MAKERS-DEVELOPMENT-GROUP/MDG-CR-10-V3-Project/BOM/MDG CR-10 V3 - BOM R1.xlsx

Sheet: READ ME
Thank you for your interest in MAKERS DEVELOPMENT GROUP, LLC'S CR-10 upgrade project.
AQUIRING PARTS FOR THE BUILD
There are many ways to build your MDG CR-10.
MDG is now offering our popular MDG CR-10 Upgrade kit with all 3D printed parts. You're welcome to print & source your own parts and upgrade your CR-10 3D printer.
This option is for those that enjoy sourcing all the componets and printing their own parts.
Please use our affiliate links on the BOM page to support our business and enable us to provide more designs.
For amazon links please note the link expires after 24 hours so please make your purchase within that
time period so we can get credit.
Alternativly, you can Buy a Complete Kit directly from our webstore
This is the easiset option as all required parts will come from a single purchase.
***********************************************************************************************
Please note MDG makes all our own aluminum parts, we do not allow others to make them on our
behalf, please support our business by buying all aluminum parts directly from us.
engineering of any MDG parts is forebidden.
See LEGAL section for full tems of use pertaining to this BOM

Sheet: MDG CR-10 - BOM
MDG CR-10 V2/V3 UPGRADE PROJECT - BILL OF MATERIALS
ITEM | QTY | PART NUMBER | DESCRIPTION
1 | 1 | 10-0001 | MDG X-AXIS DUAL LINEAR RAIL PLATE, 400MM (https://github.com/MAKERS-DEVELOPMENT-GROUP/MDG-CR-10-V3-Project/tree/main/STL)
2 | 1 | 10-0002 | MDG TOOL BASE, CR-10 V2 /V3 (https://github.com/MAKERS-DEVELOPMENT-GROUP/MDG-CR-10-V3-Project/tree/main/STL)
3 | 1 | 10-0003 | MDG-EXTRUDER MOUNT, CR10-V2 / V3 (https://github.com/MAKERS-DEVELOPMENT-GROUP/MDG-CR-10-V3-Project/tree/main/STL)
4 | 1 | 10-0004 | MDG DUAL-Y LINEAR RAIL MOUNT, CR10 V2 / V3 LEFT (https://github.com/MAKERS-DEVELOPMENT-GROUP/MDG-CR-10-V3-Project/tree/main/STL)
5 | 1 | 10-0005 | MDG DUAL-Y LINEAR RAIL MOUNT, CR10 V2 /V3 RIGHT (https://www.makersdevelopmentgroup.com/product-page/mdg-dual-y-linear-rail-mount-l-r-set-cr10-v2-v3)
6 | 3 | 10-0006 | MDG-X AXIS END STOP (https://www.makersdevelopmentgroup.com/product-page/x-axis-end-stop-cr-10)
7 | 1 | 10-0007 | MDG-X AXIS LIMIT SWITCH PLATE (https://www.makersdevelopmentgroup.com/product-page/x-axis-end-stop-cr-10)
8 | 1 | 10-0008 | MDG X-AXIS TIMING BELT CLAMP (https://www.makersdevelopmentgroup.com/product-page/gt2-timing-belt-clamp-vertical-6mm)
9 | 6 | 10-0009 | MDG Z AXIS SPACER (https://www.makersdevelopmentgroup.com/product-page/mdg-z-axis-spacer-cr-10)
10 | 1 | 10-0010 | MDG Z RAIL SUPPORT LEFT, CR10 (https://www.makersdevelopmentgroup.com/product-page/z-axis-linear-rail-mount-set-cr-10)
11 | 1 | 10-0011 | MDG Z RAIL SUPPORT RIGHT, CR10 (https://www.makersdevelopmentgroup.com/product-page/z-axis-linear-rail-mount-set-cr-10)
12 | 1 | 10-0012 | MDG Z RAIL UPPER SUPPORT, LEFT, CR10 / ENDER 3 (https://www.makersdevelopmentgroup.com/product-page/z-axis-linear-rail-mount-set-cr-10)
13 | 1 | 10-0013 | MDG Z RAIL UPPER SUPPORT, RIGHT, CR10 / ENDER 3 (https://www.makersdevelopmentgroup.com/product-page/z-axis-linear-rail-mount-set-cr-10)
14 | 1 | 10-0014 | MDG ADJUSTABLE Z-AXIS LIMIT SWITCH PLATE, CR-10 (https://www.makersdevelopmentgroup.com/product-page/adjustable-z-axis-limit-switch-plate-cr-10)
15 | 1 | 10-0034 | MDG SOLID BED LEVEL SPACER SET, CR-10/ENDER 3 (https://www.makersdevelopmentgroup.com/product-page/mdg-solid-bed-level-spacer-set-cr10-ender-3)
16 | 40 | HLN-M3X0.5 | HEX LOCK NUT (https://amzn.to/35UMeI6)
17 | 6 | HLN-M5X0.8 | HEX LOCK NUT (https://amzn.to/3pOCWFH)
18 | 1 | HLN-M6X1 | HEX LOCK NUT (https://amzn.to/3ft75W0)
19 | 2 | M119A2A154 | SHCS (https://amzn.to/3lYWwN7)
20 | 24 | M119A2A160 | SHCS (https://amzn.to/35XCZqU)
21 | 88 | M119A2A161 | SHCS (https://amzn.to/33bXQF0)
22 | 40 | M119A2A162 | SHCS (https://amzn.to/33afzwA)
23 | 7 | M119A2A163 | SHCS (https://amzn.to/35WZcoV)
24 | 7 | M119A2A164 | SHCS (https://amzn.to/3989sws)
25 | 10 | M119A2A178 | SHCS (https://amzn.to/398aKaN)
26 | 6 | M119A2A188 | SHCS (https://amzn.to/35UjjUH)
27 | 16 | M120A2A178 | BHCS (https://amzn.to/2URF0hE)
28 | 4 | M12A5C3 | PLAIN WASHER (https://amzn.to/3nUd3T7)
29 | 6 | M12A5C5 | PLAIN WASHER (https://amzn.to/3kXEGbZ)
30 | 1 | MDG-GT2B-2P-6W-1M | GT2 BELT (https://amzn.to/2KtRpXb)
31 | 2 | MDG-LR09-1H-400 | LINEAR RAIL, 9MM X 400MM, SS (https://amzn.to/3pNZeqW)
32 | 2 | MDG-LR12-1H-500 | LINEAR RAIL, 12MM (https://amzn.to/39735JJ)
33 | 2 | MDG-LR12-2H-450 | LINEAR RAIL, 12MM WITH 2 H-STYLE CARRIAGES, SS (https://amzn.to/2KvB18F)
34 | 1 | SB-A201 | SHOULDER BOLT (https://www.mcmaster.com/92981A201/)
35 | 1 | SBS-A263 | SHIM (https://www.mcmaster.com/91437A263/)
36 | 1 | SBS-A282 | SHIM (https://www.mcmaster.com/91437A282/)
37 | 76 | TN-2020-M3 | T-NUT, 2020 (https://amzn.to/3pWzc55)
38 | 20 | TN-2020-M5 | T-NUT, 2020 (https://amzn.to/2IViW3E)

Sheet: MDG CR-10 - OPTIONAL BOM
ITEM | DESCRIPTION | NOTES
1 | CREALITY CR-10 V3 (https://amzn.to/3G3XJhp) | BASE 3D PRINTER FOR BUILD PROJECT
2 | NEMA 17 STEPPER, 60 MM (https://amzn.to/3fveRPh) | FOR ADDED TORQUE / SPEED ON X/Y AXIS
3 | NEMA 17 STEPPER, 23 MM (https://amzn.to/3fptTWO) | FOR REDUCED WEIGHT OF DIRECT DRIVE EXTRUDER
4 | BTT SKR 1.4 TURBO W/(5) TMC2208 (https://amzn.to/33axjaS) | UPGRADED CONTROL BOARD.
5 | BTT SKR 1.4 TURBO W/(5) TMC2209 (https://amzn.to/35VlbfJ) | UPGRADED CONTROL BOARD.
6 | BTT SKR 1.4 TURBO W/(5) TMC2209 & TFT35 V3.0 (https://amzn.to/397sxPg) | UPGRADED CONTROL BOARD & TOUCH SCREEN
7 | ULTISTIK TEXTURED PEI SHEET (https://amzn.to/2KDglvL) | GREAT FOR PETG
8 | ANTI-BACKLASH NUTS (https://amzn.to/398N1qR) | SMOOTHER THEN OEM BRASS LEADNUTS
9 | BL TOUCH KIT, CR-10 V2 / V3 (https://amzn.to/338vFGM) | BED LEVELING KIT COMPATABLE WITH MDG UPGRADES
10 | SILICONE SOCK (https://amzn.to/3nVYuyt) | REPLACEMENT SOCK
11 | 3-2-1 MACHINE BLOCKS (https://amzn.to/395D0ed) | FOR SQUARING X-AXIS TO THE BED
13 | DIAL INDICATOR (https://amzn.to/2UT79F9) | FOR ALIGNING LINEAR RAILS PERFECTLY
14 | DIAL INDICATOR MAGNETIC BASE (https://amzn.to/3nTv9Vl) | DIAL INDICATOR MOUNT

Sheet: LEGAL
LEGAL TERMS
THIS BILL OF MATERIAL AND DATA EMBODY PROPRIETARY INFORMATION WHICH IS THE CONFIDENTIAL
PROPERTY OF MAKERS DEVELOPMENT GROUP, LLC AND SHALL NOT BE COPIED, REPRODUCED, DISCLOSED
TO OTHERS, OR OTHERWISE USED IN WHOLE OR IN PART IN ANY MATTER PREJUDICIAL TO THE
INTERESTS OF MAKERS DEVELOPMENT GROUP, LLC WITHOUT EXPRESS WRITTEN CONSENT OF MAKERS
DEVELOPMENT GROUP, LLC. MAKERS DEVELOPMENT GROUP, LLC EXPRESSLY RESERVES ALL DESIGN,
MANUFACTURING USE, REPRODUCTION AND SALES RIGHTS IN AND TO ALL INFORMATION CONTAINED IN
OR DISCLOSED BY THIS DOCUMENT. THIS BILL OF MATERIAL IS LOANED IN CONFIDENCE WITH THE
UNDERSTANDING IT SHALL BE RETURNED ON DEMAND. ACCEPTANCE OF THIS BILL OF MATERIAL SHALL
BE CONSTRUED AS AN AGREEMENT TO OBSERVE THE FOREGOING CONDITIONS AND AS AN ADMISSION
THAT MAKERS DEVELOPMENT GROUP, LLCIS THE EXCLUSIVE OWNER OF THIS BILL OF MATERIAL.
"MAKERS DEVELOPMENT GROUP, LLCEXPRESSLY RESERVES ALL DESIGN, MANUFACTURING USE,
REPRODUCTION, SALES RIGHTS IN AND TO ALL INFORMATION CONTAINED OR DISCLOSED BY THIS
DOCUMENT."
