MAKERS-DEVELOPMENT-GROUP/MDG-CR-10-V3-Project/BOM/MDG CR-10 V3 - BOM R0.xlsx

Sheet: READ ME
Thank you for your interest in MAKERS DEVELOPMENT GROUP, LLC'S CR-10 upgrade project.
AQUIRING PARTS FOR THE BUILD
There are many ways to build your MDG CR-10.
1.) Buy a Complete Kit directly from our webstore
This is the easiset option as all required parts will come from a single purchase from our webstore.
As such this is our recommneded option.
2.) Buy each axis upgrade individually from our webstore
This is the option if you wish to upgrade over time. If you go down this path we recommend upgrading
the Y-axis first, X-axis second, and Z-axis third. You can purchase each axis upgrade kit directly from our webstore
3.) Buy aluminum parts & 3D printed parts kit from our store.
This option is for those that enjoy sourcing all the componets themselves.
Please use our affiliate links so theY can support our business and enable us to provide more designs.
For amazon links please note the link expires after 24 hours so please make your purchase within that
time period so we can get credit.
Please note by the time you factor in shipping costs from multiple sources this will likely be more
expensive then just purchasing the kits from MDG
4.) Buy aluminum parts from our webstore & 3D print your own parts
This option is for those that enjoy sourcing all the componets and printing their own parts.
Please use our affiliate links so the can support our business and enable us to provide more designs.
For amazon links please note the link expires after 24 hours so please make your purchase within that
time period so we can get credit.
***********************************************************************************************
Please note MDG makes all our own aluminum parts, we do not allow others to make them on our
behalf, please support our business by buying all aluminum parts directly from us. Reverse
engineering of any MDG parts is forebidden.
See LEGAL section for full tems of use pertaining to this BOM

Sheet: MDG CR-10 V3 - COMPLETE BOM
ITEM | QTY | PART NUMBER | DESCRIPTION | COST | EXT COST
1 | 1 | 10-0001 | MDG X-AXIS DUAL LINEAR RAIL PLATE, 400MM (https://www.makersdevelopmentgroup.com/product-page/mdg-x-axis-dual-linear-rail-plate-400-mm-cr-10) | $99.00 | $99.00
2 | 1 | 10-0002 | MDG TOOL BASE, CR-10 V2 /V3 (https://www.makersdevelopmentgroup.com/product-page/mdg-x-axis-tool-base-cr-10-v2-v3) | $39.00 | $39.00
3 | 1 | 10-0003 | MDG-EXTRUDER MOUNT, CR10-V2 / V3 (https://www.makersdevelopmentgroup.com/product-page/mdg-extruder-hotend-mount-cr-10-v2-v3) | $39.00 | $39.00
4 | 1 | 10-0004 | MDG DUAL-Y LINEAR RAIL MOUNT, CR10 V2 / V3 LEFT (https://www.makersdevelopmentgroup.com/product-page/mdg-dual-y-linear-rail-mount-l-r-set-cr10-v2-v3) | $57.95 | $57.95
5 | 1 | 10-0005 | MDG DUAL-Y LINEAR RAIL MOUNT, CR10 V2 /V3 RIGHT (https://www.makersdevelopmentgroup.com/product-page/mdg-dual-y-linear-rail-mount-l-r-set-cr10-v2-v3) |  | $0.00
6 | 3 | 10-0006 | MDG-X AXIS END STOP (https://www.makersdevelopmentgroup.com/product-page/x-axis-end-stop-cr-10) | $3.53 | $10.59
7 | 1 | 10-0007 | MDG-X AXIS LIMIT SWITCH PLATE (https://www.makersdevelopmentgroup.com/product-page/x-axis-end-stop-cr-10) | $3.53 | $3.53
8 | 1 | 10-0008 | MDG X-AXIS TIMING BELT CLAMP (https://www.makersdevelopmentgroup.com/product-page/gt2-timing-belt-clamp-vertical-6mm) | $3.93 | $3.93
9 | 6 | 10-0009 | MDG Z AXIS SPACER (https://www.makersdevelopmentgroup.com/product-page/mdg-z-axis-spacer-cr-10) | $4.95 | $29.70
10 | 1 | 10-0010 | MDG Z RAIL SUPPORT LEFT, CR10 (https://www.makersdevelopmentgroup.com/product-page/z-axis-linear-rail-mount-set-cr-10) | $3.53 | $3.53
11 | 1 | 10-0011 | MDG Z RAIL SUPPORT RIGHT, CR10 (https://www.makersdevelopmentgroup.com/product-page/z-axis-linear-rail-mount-set-cr-10) | $3.53 | $3.53
12 | 1 | 10-0012 | MDG Z RAIL UPPER SUPPORT, LEFT, CR10 / ENDER 3 (https://www.makersdevelopmentgroup.com/product-page/z-axis-linear-rail-mount-set-cr-10) | $3.53 | $3.53
13 | 1 | 10-0013 | MDG Z RAIL UPPER SUPPORT, RIGHT, CR10 / ENDER 3 (https://www.makersdevelopmentgroup.com/product-page/z-axis-linear-rail-mount-set-cr-10) | $3.53 | $3.53
14 | 1 | 10-0014 | MDG ADJUSTABLE Z-AXIS LIMIT SWITCH PLATE, CR-10 (https://www.makersdevelopmentgroup.com/product-page/adjustable-z-axis-limit-switch-plate-cr-10) | $3.53 | $3.53
15 | 1 | 10-0034 | MDG SOLID BED LEVEL SPACER SET, CR-10/ENDER 3 (https://www.makersdevelopmentgroup.com/product-page/mdg-solid-bed-level-spacer-set-cr10-ender-3) | $13.95 | $13.95
16 | 40 | HLN-M3X0.5 | HEX LOCK NUT (https://amzn.to/35UMeI6) | $6.99 | $6.99
17 | 6 | HLN-M5X0.8 | HEX LOCK NUT (https://amzn.to/3pOCWFH) | $8.19 | $8.19
18 | 1 | HLN-M6X1 | HEX LOCK NUT (https://amzn.to/3ft75W0) | $6.28 | $6.28
19 | 2 | M119A2A154 | SHCS (https://amzn.to/3lYWwN7) | $10.59 | $10.59
20 | 24 | M119A2A160 | SHCS (https://amzn.to/35XCZqU) | $8.19 | $8.19
21 | 88 | M119A2A161 | SHCS (https://amzn.to/33bXQF0) | $6.99 | $6.99
22 | 40 | M119A2A162 | SHCS (https://amzn.to/33afzwA) | $6.99 | $6.99
23 | 7 | M119A2A163 | SHCS (https://amzn.to/35WZcoV) | $8.98 | $8.98
24 | 7 | M119A2A164 | SHCS (https://amzn.to/3989sws) | $9.49 | $9.49
25 | 10 | M119A2A178 | SHCS (https://amzn.to/398aKaN) | $9.19 | $9.19
26 | 6 | M119A2A188 | SHCS (https://amzn.to/35UjjUH) | $10.59 | $10.59
27 | 16 | M120A2A178 | BHCS (https://amzn.to/2URF0hE) | $11.79 | $11.79
28 | 4 | M12A5C3 | PLAIN WASHER (https://amzn.to/3nUd3T7) | $4.99 | $4.99
29 | 6 | M12A5C5 | PLAIN WASHER (https://amzn.to/3kXEGbZ) | $7.29 | $7.29
30 | 1 | MDG-GT2B-2P-6W-1M | GT2 BELT (https://amzn.to/2KtRpXb) | $11.99 | $11.99
31 | 2 | MDG-LR09-1H-400 | LINEAR RAIL, 9MM X 400MM, SS (https://amzn.to/3pNZeqW) | $24.99 | $49.98
32 | 2 | MDG-LR12-1H-500 | LINEAR RAIL, 12MM (https://amzn.to/39735JJ) | $36.99 | $73.98
33 | 2 | MDG-LR12-2H-450 | LINEAR RAIL, 12MM WITH 2 H-STYLE CARRIAGES, SS (https://amzn.to/2KvB18F) | $45.99 | $91.98
34 | 1 | SB-A201 | SHOULDER BOLT (https://www.mcmaster.com/92981A201/) | $1.57 | $1.57
35 | 1 | SBS-A263 | SHIM (https://www.mcmaster.com/91437A263/) | $9.60 | $9.60
36 | 1 | SBS-A282 | SHIM (https://www.mcmaster.com/91437A282/) | $12.75 | $12.75
37 | 76 | TN-2020-M3 | T-NUT, 2020 (https://amzn.to/3pWzc55) | $7.99 | $7.99
38 | 20 | TN-2020-M5 | T-NUT, 2020 (https://amzn.to/2IViW3E) | $7.99 | $7.99
 |  |  |  |  | $698.67

Sheet: MDG CR-10 V3 - OPTIONAL BOM
ITEM | DESCRIPTION | NOTES
1 | CREALITY CR-10 V3 (https://amzn.to/398pPsV) | BASE 3D PRINTER FOR BUILD PROJECT
2 | NEMA 17 STEPPER, 60 MM (https://amzn.to/3fveRPh) | FOR ADDED TORQUE / SPEED ON X/Y AXIS
3 | NEMA 17 STEPPER, 23 MM (https://amzn.to/3fptTWO) | FOR REDUCED WEIGHT OF DIRECT DRIVE EXTRUDER
4 | BTT SKR 1.4 TURBO W/(5) TMC2208 (https://amzn.to/33axjaS) | UPGRADED CONTROL BOARD.
5 | BTT SKR 1.4 TURBO W/(5) TMC2209 (https://amzn.to/35VlbfJ) | UPGRADED CONTROL BOARD.
6 | BTT SKR 1.4 TURBO W/(5) TMC2209 & TFT35 V3.0 (https://amzn.to/397sxPg) | UPGRADED CONTROL BOARD & TOUCH SCREEN
7 | ULTISTIK TEXTURED PEI SHEET (https://amzn.to/2KDglvL) | GREAT FOR PETG
8 | ANTI-BACKLASH NUTS (https://amzn.to/398N1qR) | SMOOTHER THEN OEM BRASS LEADNUTS
9 | BL TOUCH KIT, CR-10 V2 / V3 (https://amzn.to/338vFGM) | BED LEVELING KIT COMPATABLE WITH MDG UPGRADES
10 | SILICONE SOCK (https://amzn.to/3nVYuyt) | REPLACEMENT SOCK
11 | 3-2-1 MACHINE BLOCKS (https://amzn.to/395D0ed) | FOR SQUARING X-AXIS TO THE BED
13 | DIAL INDICATOR (https://amzn.to/2UT79F9) | FOR ALIGNING LINEAR RAILS PERFECTLY
14 | DIAL INDICATOR MAGNETIC BASE (https://amzn.to/3nTv9Vl) | DIAL INDICATOR MOUNT

Sheet: LEGAL
LEGAL TERMS
THIS BILL OF MATERIAL AND DATA EMBODY PROPRIETARY INFORMATION WHICH IS THE CONFIDENTIAL
PROPERTY OF MAKERS DEVELOPMENT GROUP, LLC AND SHALL NOT BE COPIED, REPRODUCED, DISCLOSED
TO OTHERS, OR OTHERWISE USED IN WHOLE OR IN PART IN ANY MATTER PREJUDICIAL TO THE
INTERESTS OF MAKERS DEVELOPMENT GROUP, LLC WITHOUT EXPRESS WRITTEN CONSENT OF MAKERS
DEVELOPMENT GROUP, LLC. MAKERS DEVELOPMENT GROUP, LLC EXPRESSLY RESERVES ALL DESIGN,
MANUFACTURING USE, REPRODUCTION AND SALES RIGHTS IN AND TO ALL INFORMATION CONTAINED IN
OR DISCLOSED BY THIS DOCUMENT. THIS BILL OF MATERIAL IS LOANED IN CONFIDENCE WITH THE
UNDERSTANDING IT SHALL BE RETURNED ON DEMAND. ACCEPTANCE OF THIS BILL OF MATERIAL SHALL
BE CONSTRUED AS AN AGREEMENT TO OBSERVE THE FOREGOING CONDITIONS AND AS AN ADMISSION
THAT MAKERS DEVELOPMENT GROUP, LLCIS THE EXCLUSIVE OWNER OF THIS BILL OF MATERIAL.
"MAKERS DEVELOPMENT GROUP, LLCEXPRESSLY RESERVES ALL DESIGN, MANUFACTURING USE,
REPRODUCTION, SALES RIGHTS IN AND TO ALL INFORMATION CONTAINED OR DISCLOSED BY THIS
DOCUMENT."
