MAKERS-DEVELOPMENT-GROUP/MDG-CR-10-V3-Project/STL/10-0001A#FDM.stl

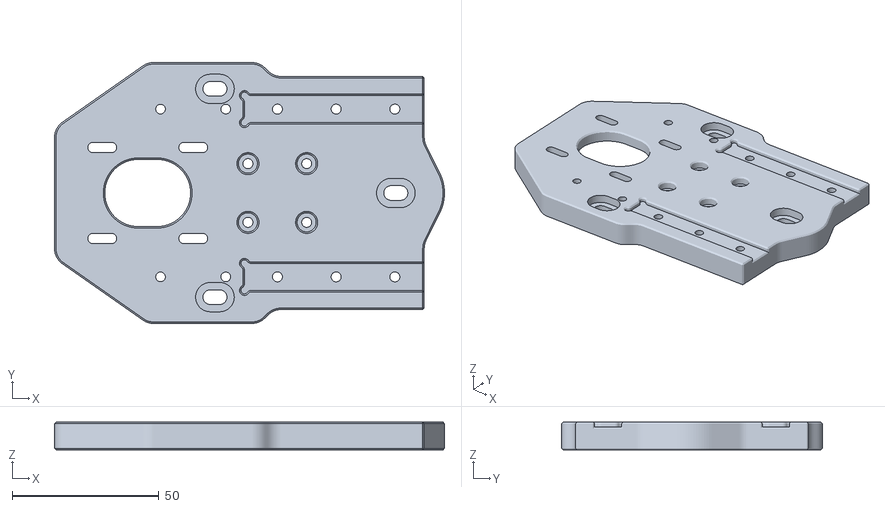
[picture p1: CAD file, 2022-12-29]
STL/10-0001A#FDM.stl
132.9 x 88.9 x 9.52
