MAKERS-DEVELOPMENT-GROUP/MDG-CR-10-V3-Project/STL/10-0001B#FDM.stl

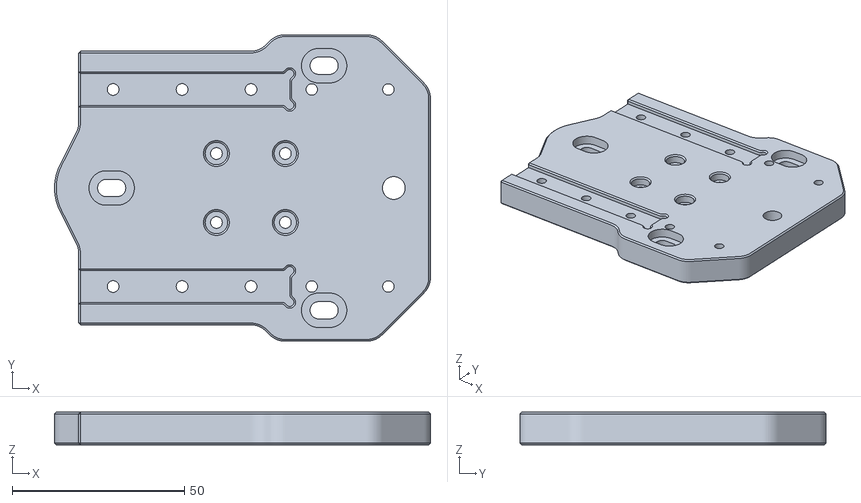
[picture p2: CAD file, 2022-12-29]
STL/10-0001B#FDM.stl
109.1 x 88.9 x 9.52
