MAKERS-DEVELOPMENT-GROUP/MDG-CR-10-V3-Project/STL/10-0001C#FDM.stl

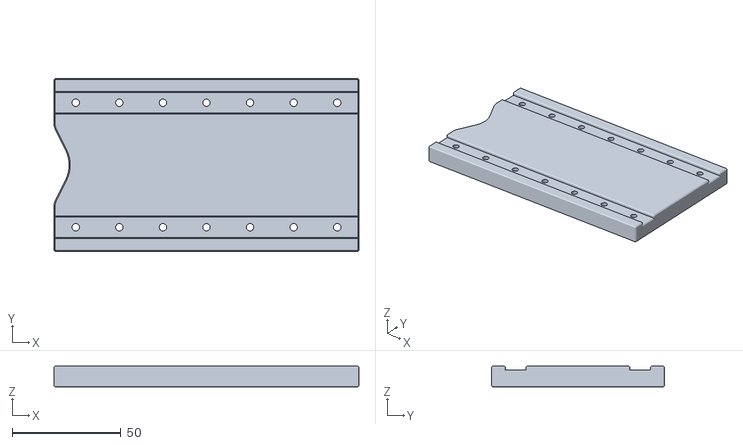
[picture p3: CAD file, 2022-12-29]
STL/10-0001C#FDM.stl
140.0 x 79.4 x 9.52
