MAKERS-DEVELOPMENT-GROUP/MDG-CR-10-V3-Project/STL/10-0002#FDM.stl

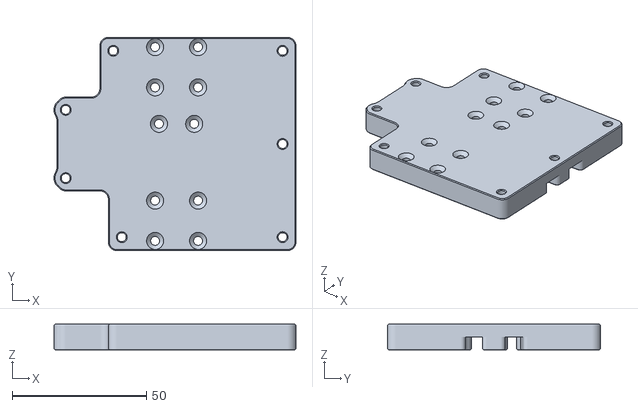
[picture p4: CAD file, 2022-12-29]
STL/10-0002#FDM.stl
90.1 x 79.4 x 9.52
