MAKERS-DEVELOPMENT-GROUP/MDG-CR-10-V3-Project/STL/10-0009#FDM.stl

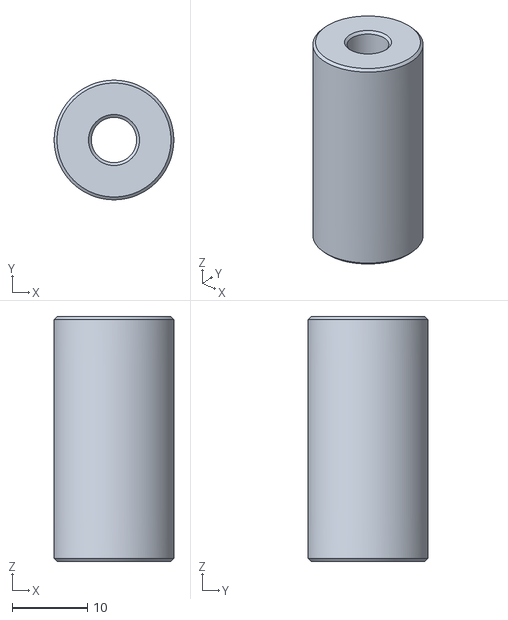
[picture p5: CAD file, 2022-12-29]
STL/10-0009#FDM.stl
15.9 x 15.9 x 32.5
