MAKERS-DEVELOPMENT-GROUP/MDG-CR-10-V3-Project/STL/10-0003#FDM.stl

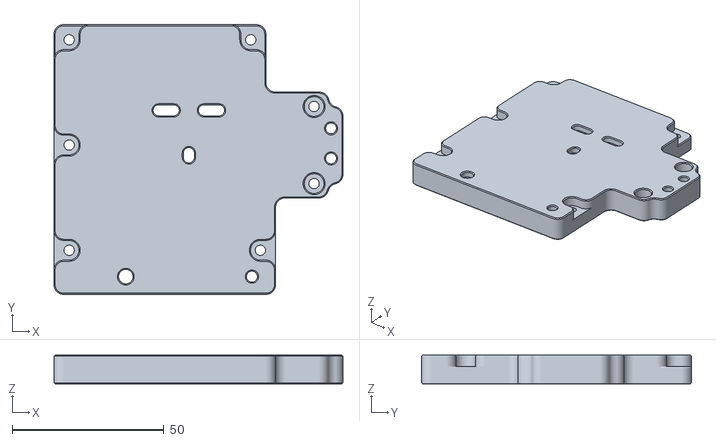
[picture p6: CAD file, 2022-12-29]
STL/10-0003#FDM.stl
95.2 x 88.9 x 9.52
