MAKERS-DEVELOPMENT-GROUP/MDG-CR-10-V3-Project/STL/10-0004#FDM.stl

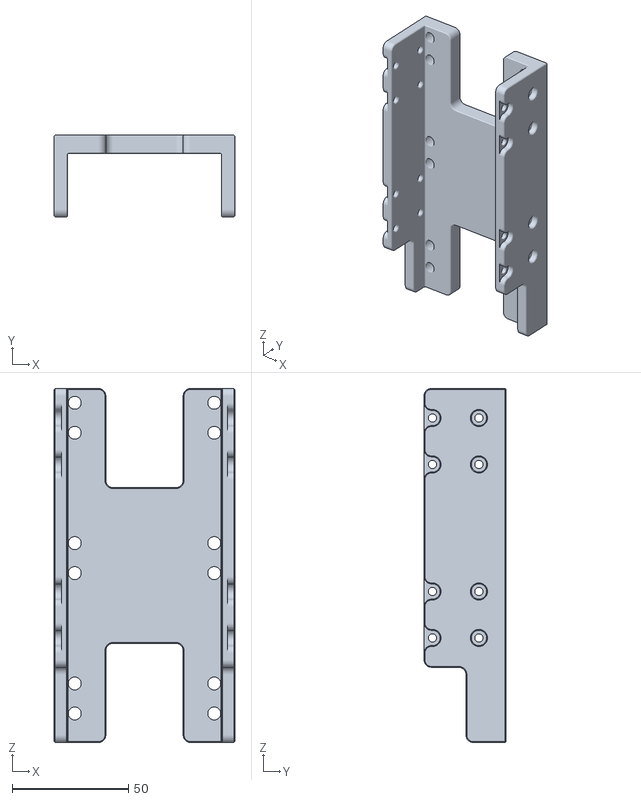
[picture p7: CAD file, 2022-12-29]
STL/10-0004#FDM.stl
77.7 x 35.3 x 152.4
