MAKERS-DEVELOPMENT-GROUP/MDG-CR-10-V3-Project/STL/10-0008#0.stl

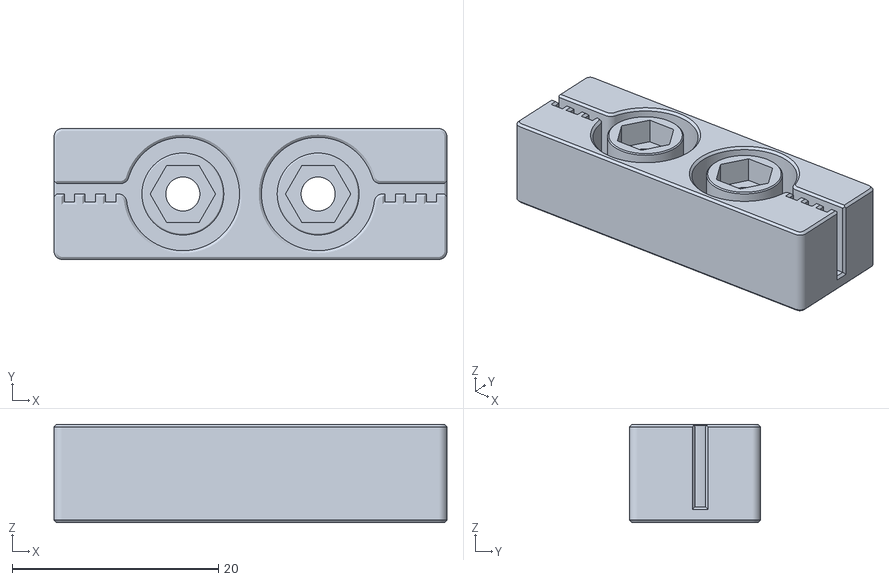
[picture p8: CAD file, 2022-12-29]
STL/10-0008#0.stl
38.1 x 12.7 x 9.52
