MAKERS-DEVELOPMENT-GROUP/MDG-CR-10-V3-Project/STL/10-0051B.stl

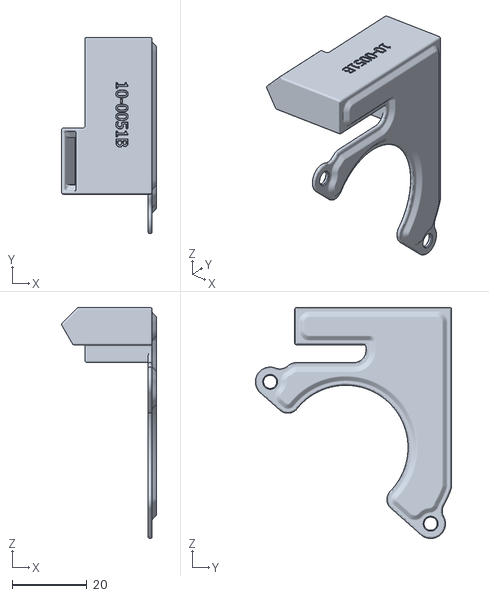
[picture p9: CAD file, 2021-04-24]
STL/10-0051B.stl
25.4 x 52.6 x 61.9
