MAKERS-DEVELOPMENT-GROUP/MDG-CR-10-V3-Project/STL/10-0003#9.stl

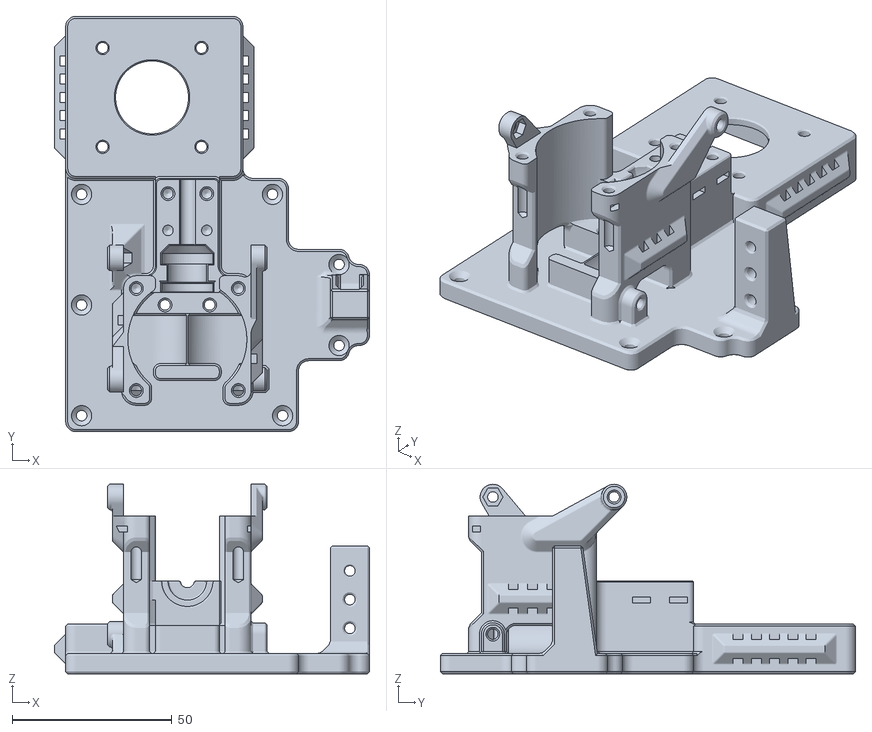
[picture p11: CAD file, 2021-04-24]
STL/10-0003#9.stl
98.7 x 130.2 x 59.4
