MAKERS-DEVELOPMENT-GROUP/MDG-CR-10-V3-Project/STL/10-0003#7.stl

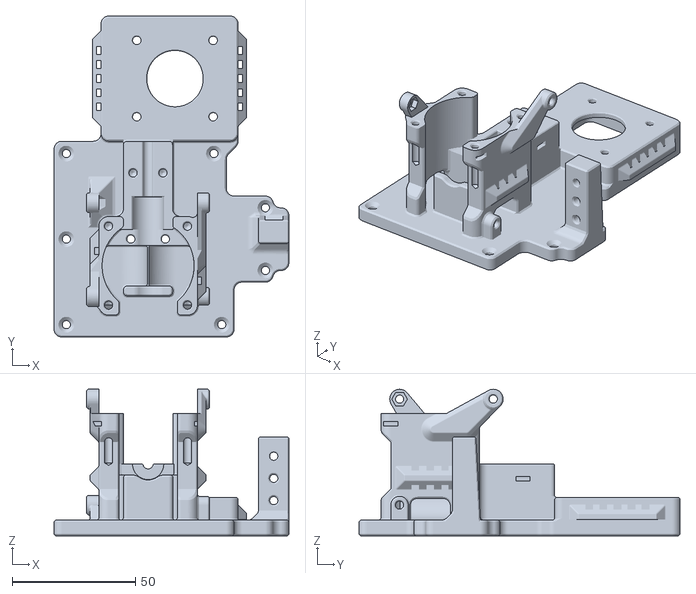
[picture p12: CAD file, 2021-04-24]
STL/10-0003#7.stl
95.2 x 130.2 x 59.4
