MAKERS-DEVELOPMENT-GROUP/MDG-CR-10-V3-Project/STL/10-0003#0.stl

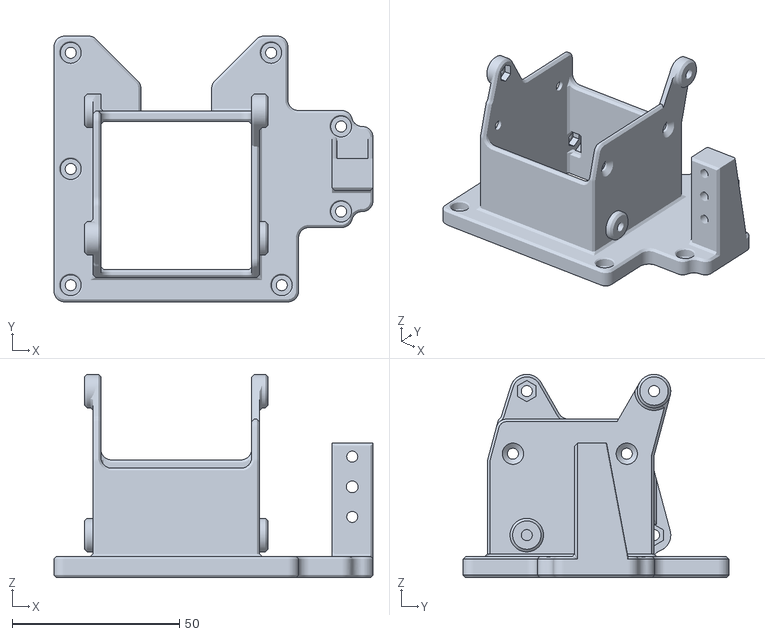
[picture p13: CAD file, 2021-04-24]
STL/10-0003#0.stl
95.2 x 79.4 x 60.7
