MAKERS-DEVELOPMENT-GROUP/MDG-CR-10-V3-Project/STL/10-0018A.stl

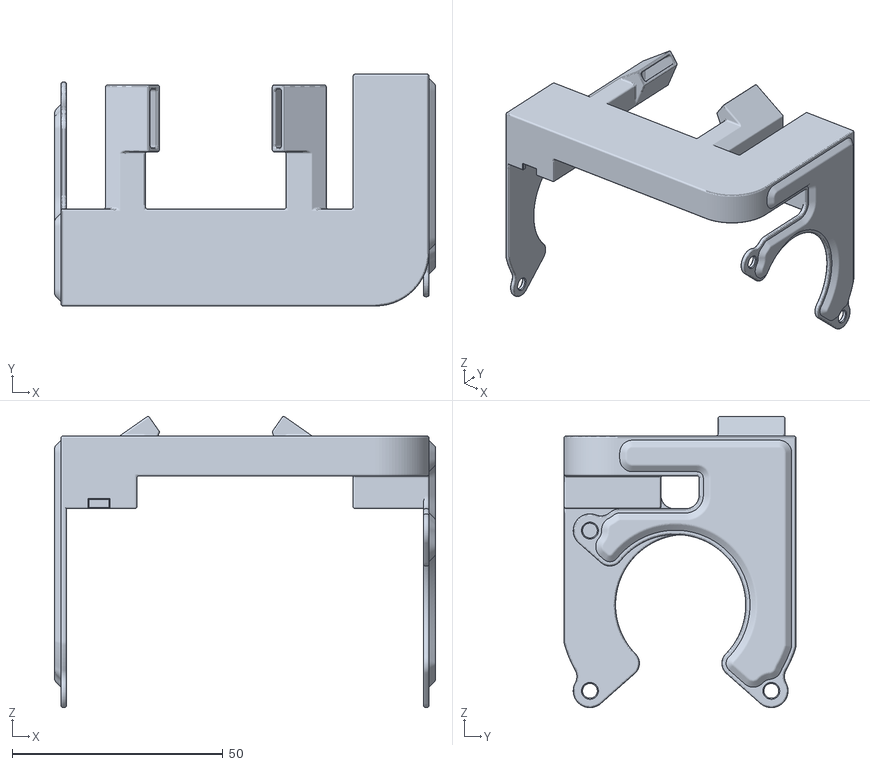
[picture p14: CAD file, 2021-04-24]
STL/10-0018A.stl
90.3 x 55.0 x 69.0
