MAKERS-DEVELOPMENT-GROUP/MDG-CR-10-V3-Project/STL/10-0050.stl

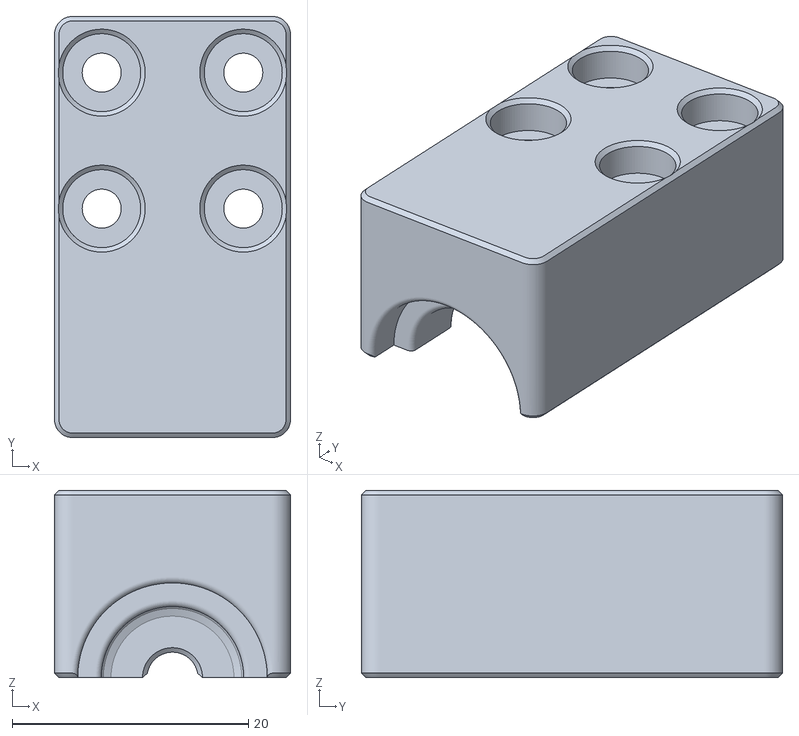
[picture p15: CAD file, 2021-02-17]
STL/10-0050.stl
20.0 x 35.7 x 15.9
