MAKERS-DEVELOPMENT-GROUP/MDG-CR-10-V3-Project/STL/10-0018A#0.stl

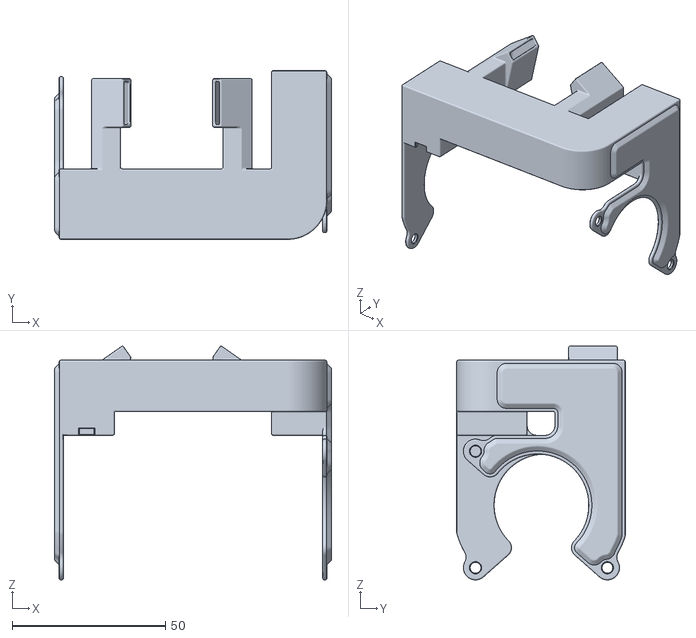
[picture p16: CAD file, 2021-02-17]
STL/10-0018A#0.stl
90.3 x 55.0 x 76.3
