MAKERS-DEVELOPMENT-GROUP/MDG-CR-10-V3-Project/STL/10-0012.stl

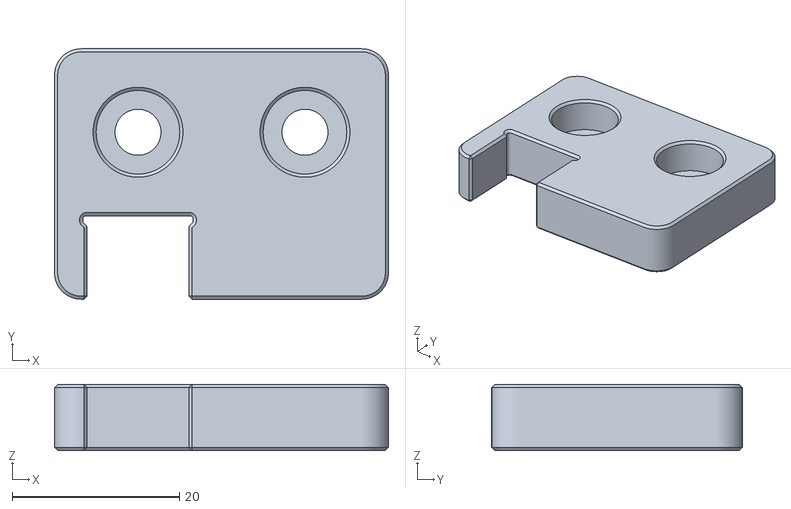
[picture p17: CAD file, 2020-12-29]
STL/10-0012.stl
40.0 x 30.0 x 7.94
