MAKERS-DEVELOPMENT-GROUP/MDG-CR-10-V3-Project/STL/10-0014.stl

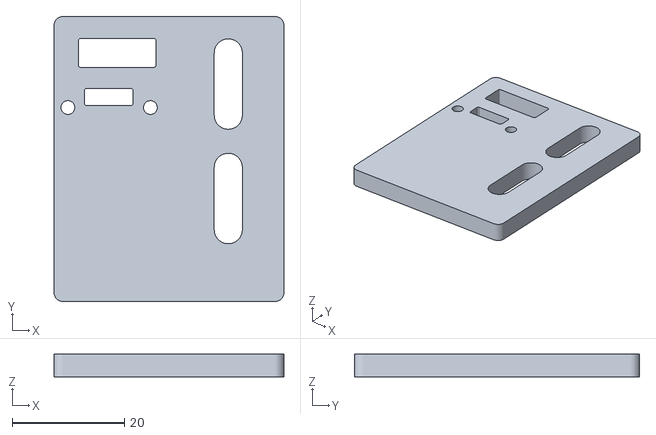
[picture p18: CAD file, 2020-12-29]
STL/10-0014.stl
41.0 x 50.8 x 4.06
