MAKERS-DEVELOPMENT-GROUP/MDG-CR-10-V3-Project/STL/10-0011.stl

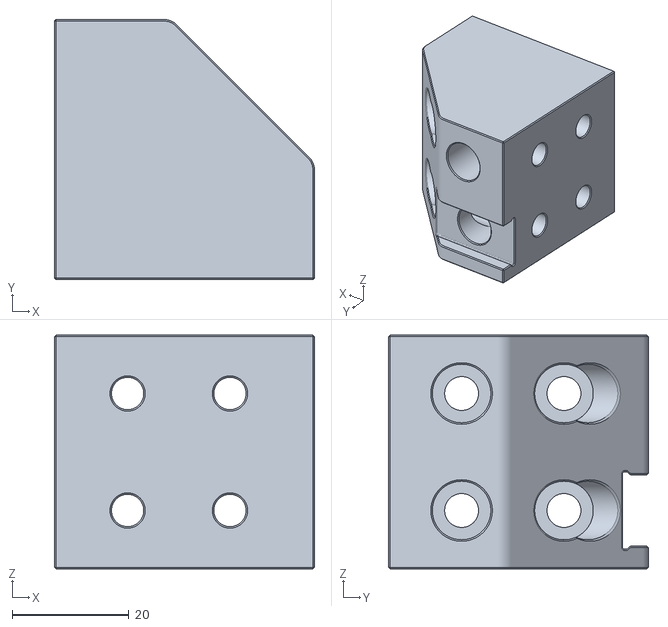
[picture p19: CAD file, 2020-12-29]
STL/10-0011.stl
44.5 x 44.5 x 40.0
