MAKERS-DEVELOPMENT-GROUP/MDG-CR-10-V3-Project/STL/10-0006.stl

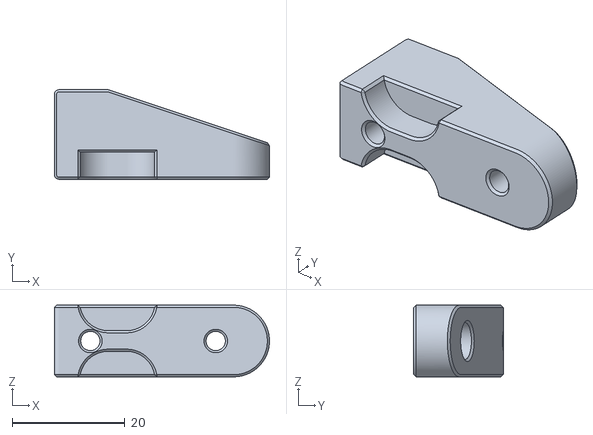
[picture p20: CAD file, 2020-12-29]
STL/10-0006.stl
38.1 x 15.9 x 12.7
