MAKERS-DEVELOPMENT-GROUP/MDG-CR-10-V3-Project/STL/10-0007.stl

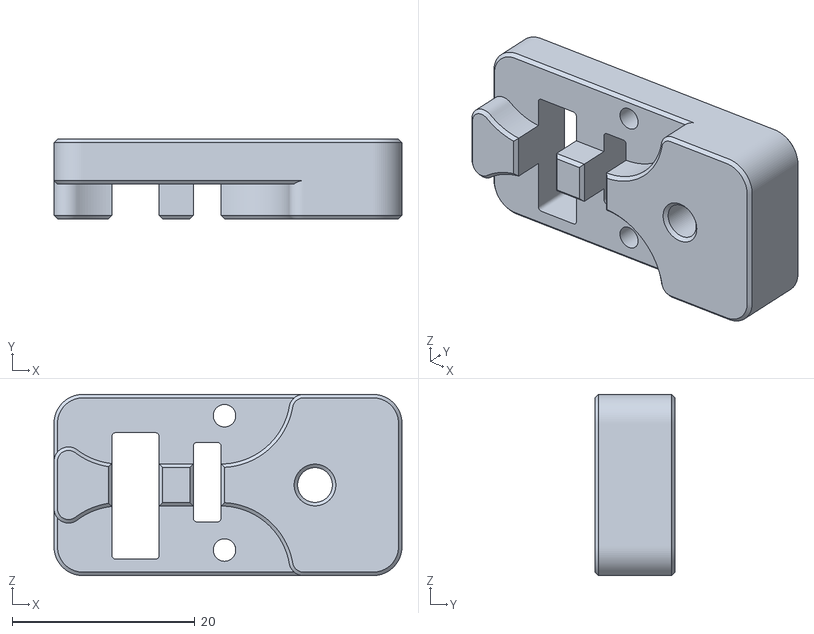
[picture p21: CAD file, 2020-12-29]
STL/10-0007.stl
38.1 x 8.73 x 19.8
