MAKERS-DEVELOPMENT-GROUP/MDG-CR-10-V3-Project/(list of files, cad)

Other CAD files:
STL/10-0003#6.stl
STL/10-0003#3.stl
STL/10-0003#5.stl
STL/10-0003#8.stl
STL/10-0003#2.stl
STL/10-0003#1.stl
STL/10-0008.stl
STL/10-0003.stl
STL/10-0013.stl
STL/10-0010.stl
