MAKERS-DEVELOPMENT-GROUP/MDG-CR-10-V3-Project/ASSEMBLY DRAWINGS/10-0046#0.pdf

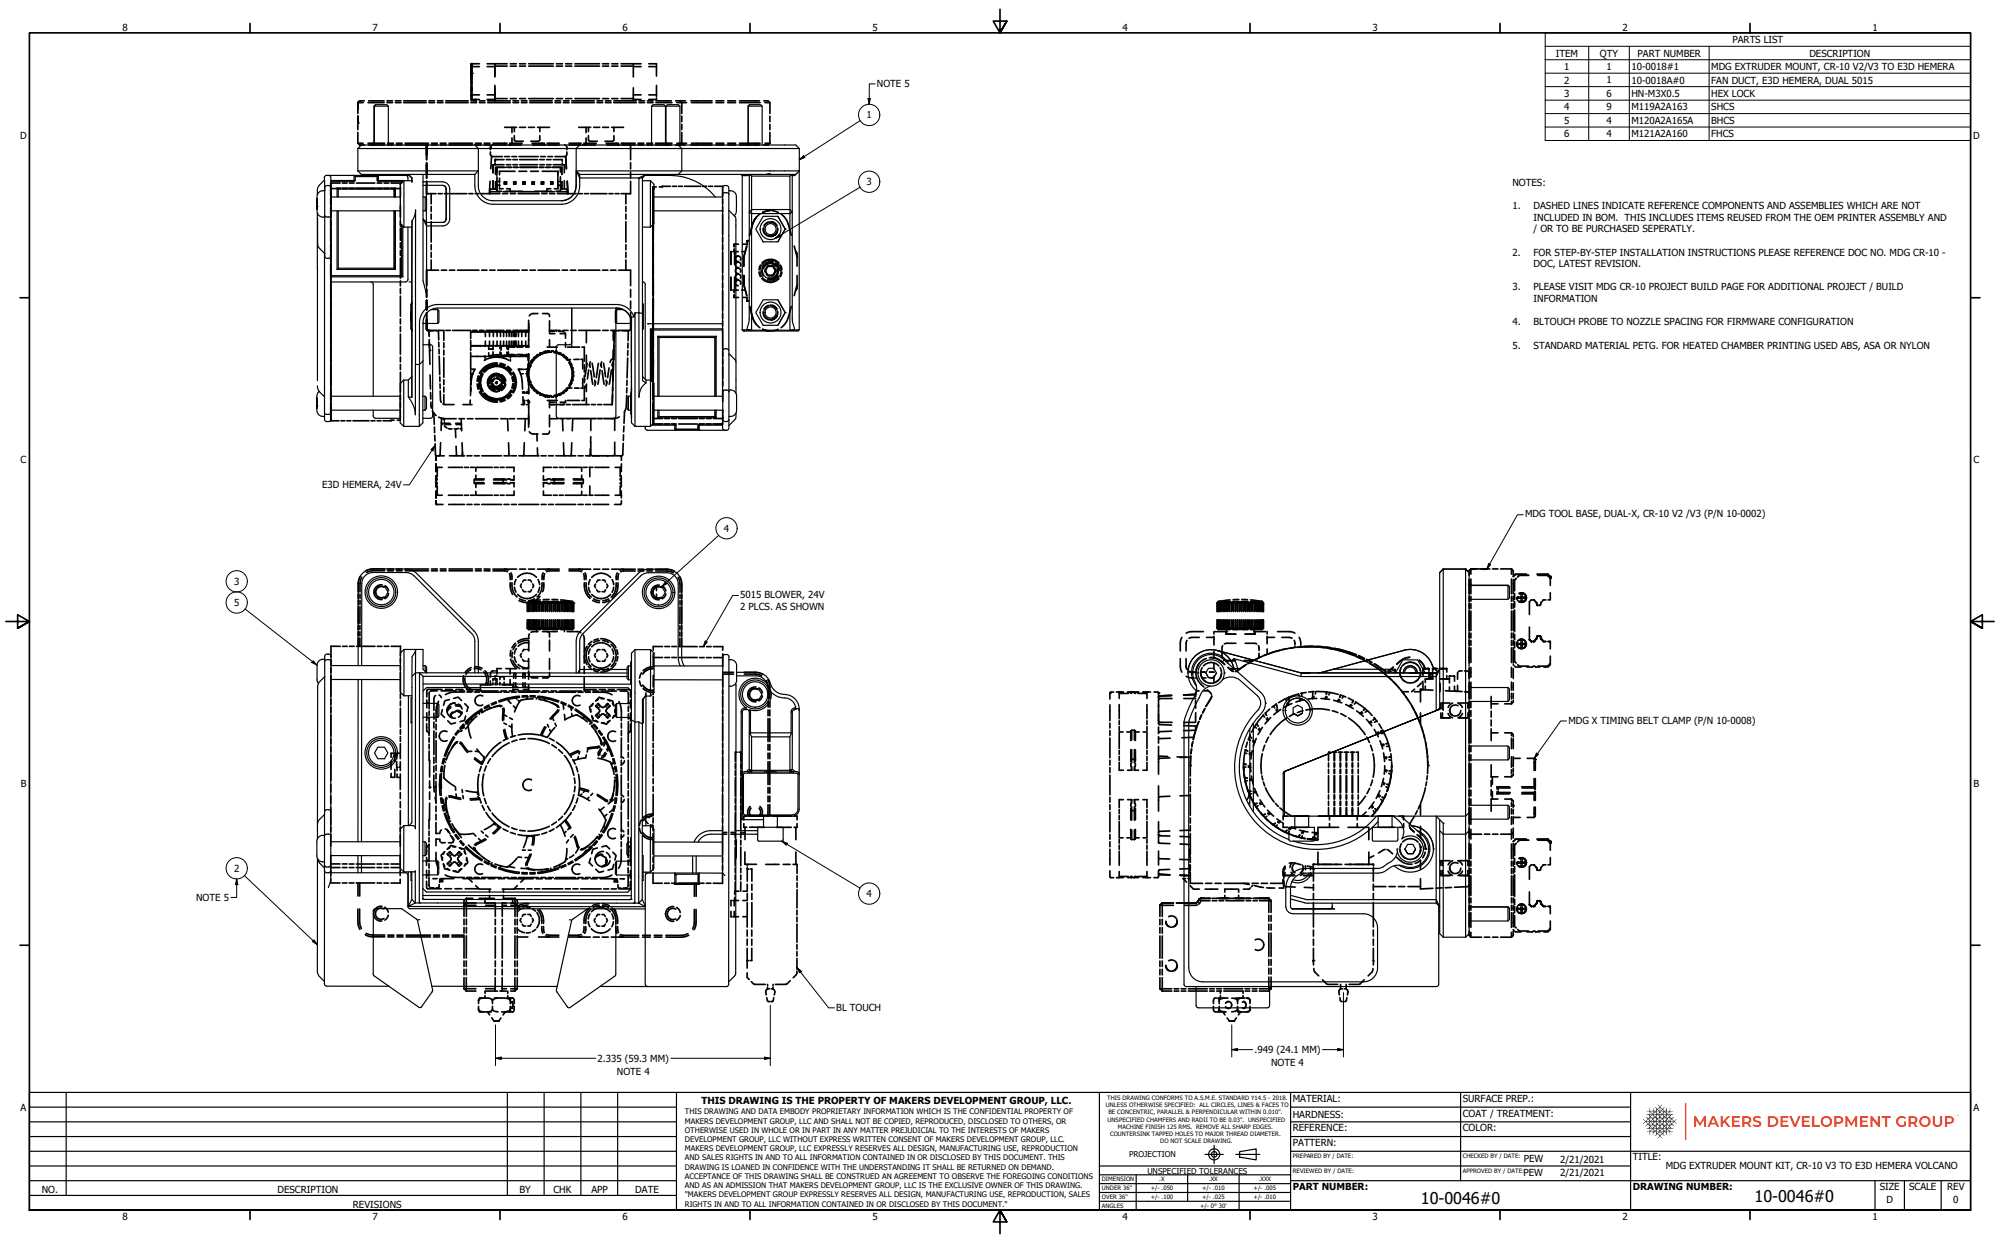
[picture p22: page 1]
PARTS LIST; ITEM; QTY; PART NUMBER; DESCRIPTION; MDG EXTRUDER MOUNT, CR-10 V2/V3 TO E3D HEMERA; FAN DUCT, E3D HEMERA, DUAL 5015; HEX LOCK; UNSPECIFIED TOLERANCES; UNDER 36"; OVER 36"; DRAWING NUMBER:; REV; COAT / TREATMENT:; SURFACE PREP.:; 2.335 (59.3 MM) NOTE 4; .949 (24.1 MM) NOTE 4; BL TOUCH; E3D HEMERA, 24V; NOTE 5

1. DASHED LINES INDICATE REFERENCE COMPONENTS AND ASSEMBLIES WHICH ARE NOT
INCLUDED IN BOM. THIS INCLUDES ITEMS REUSED FROM THE OEM PRINTER ASSEMBLY AND
/ OR TO BE PURCHASED SEPERATLY.

2. FOR STEP-BY-STEP INSTALLATION INSTRUCTIONS PLEASE REFERENCE DOC NO. MDG CR-10 -
DOC, LATEST REVISION.

3. PLEASE VISIT MDG CR-10 PROJECT BUILD PAGE FOR ADDITIONAL PROJECT / BUILD
INFORMATION

4. BLTOUCH PROBE TO NOZZLE SPACING FOR FIRMWARE CONFIGURATION

5. STANDARD MATERIAL PETG. FOR HEATED CHAMBER PRINTING USED ABS, ASA OR NYLON

MDG TOOL BASE, DUAL-X, CR-10 V2 /V3 (P/N 10-0002)

5015 BLOWER, 24V
2 PLCS. AS SHOWN

MDG X TIMING BELT CLAMP (P/N 10-0008)

THIS DRAWING CONFORMS TO A.S.M.E. STANDARD Y14.5 - 2018.
UNLESS OTHERWISE SPECIFIED: ALL CIRCLES, LINES & FACES TO
BE CONCENTRIC, PARALLEL & PERPENDICULAR WITHIN 0.010".
UNSPECIFIED CHAMFERS AND RADII TO BE 0.03". UNSPECIFIED
MACHINE FINISH 125 RMS. REMOVE ALL SHARP EDGES.
COUNTERSINK TAPPED HOLES TO MAJOR THREAD DIAMETER.

THIS DRAWING IS THE PROPERTY OF MAKERS DEVELOPMENT GROUP, LLC.
THIS DRAWING AND DATA EMBODY PROPRIETARY INFORMATION WHICH IS THE CONFIDENTIAL PROPERTY OF
MAKERS DEVELOPMENT GROUP, LLC AND SHALL NOT BE COPIED, REPRODUCED, DISCLOSED TO OTHERS, OR
OTHERWISE USED IN WHOLE OR IN PART IN ANY MATTER PREJUDICIAL TO THE INTERESTS OF MAKERS
DEVELOPMENT GROUP, LLC WITHOUT EXPRESS WRITTEN CONSENT OF MAKERS DEVELOPMENT GROUP, LLC.
MAKERS DEVELOPMENT GROUP, LLC EXPRESSLY RESERVES ALL DESIGN, MANUFACTURING USE, REPRODUCTION
AND SALES RIGHTS IN AND TO ALL INFORMATION CONTAINED IN OR DISCLOSED BY THIS DOCUMENT. THIS
DRAWING IS LOANED IN CONFIDENCE WITH THE UNDERSTANDING IT SHALL BE RETURNED ON DEMAND.
ACCEPTANCE OF THIS DRAWING SHALL BE CONSTRUED AN AGREEMENT TO OBSERVE THE FOREGOING CONDITIONS
AND AS AN ADMISSION THAT MAKERS DEVELOPMENT GROUP, LLC IS THE EXCLUSIVE OWNER OF THIS DRAWING.
"MAKERS DEVELOPMENT GROUP EXPRESSLY RESERVES ALL DESIGN, MANUFACTURING USE, REPRODUCTION, SALES
RIGHTS IN AND TO ALL INFORMATION CONTAINED IN OR DISCLOSED BY THIS DOCUMENT."

DO NOT SCALE DRAWING.

PREPARED BY / DATE:

CHECKED BY / DATE:

MDG EXTRUDER MOUNT KIT, CR-10 V3 TO E3D HEMERA VOLCANO

REVIEWED BY / DATE:
PART NUMBER:

APPROVED BY / DATE:
