MAKERS-DEVELOPMENT-GROUP/MDG-CR-10-V3-Project/ASSEMBLY DRAWINGS/10-0052#0.pdf

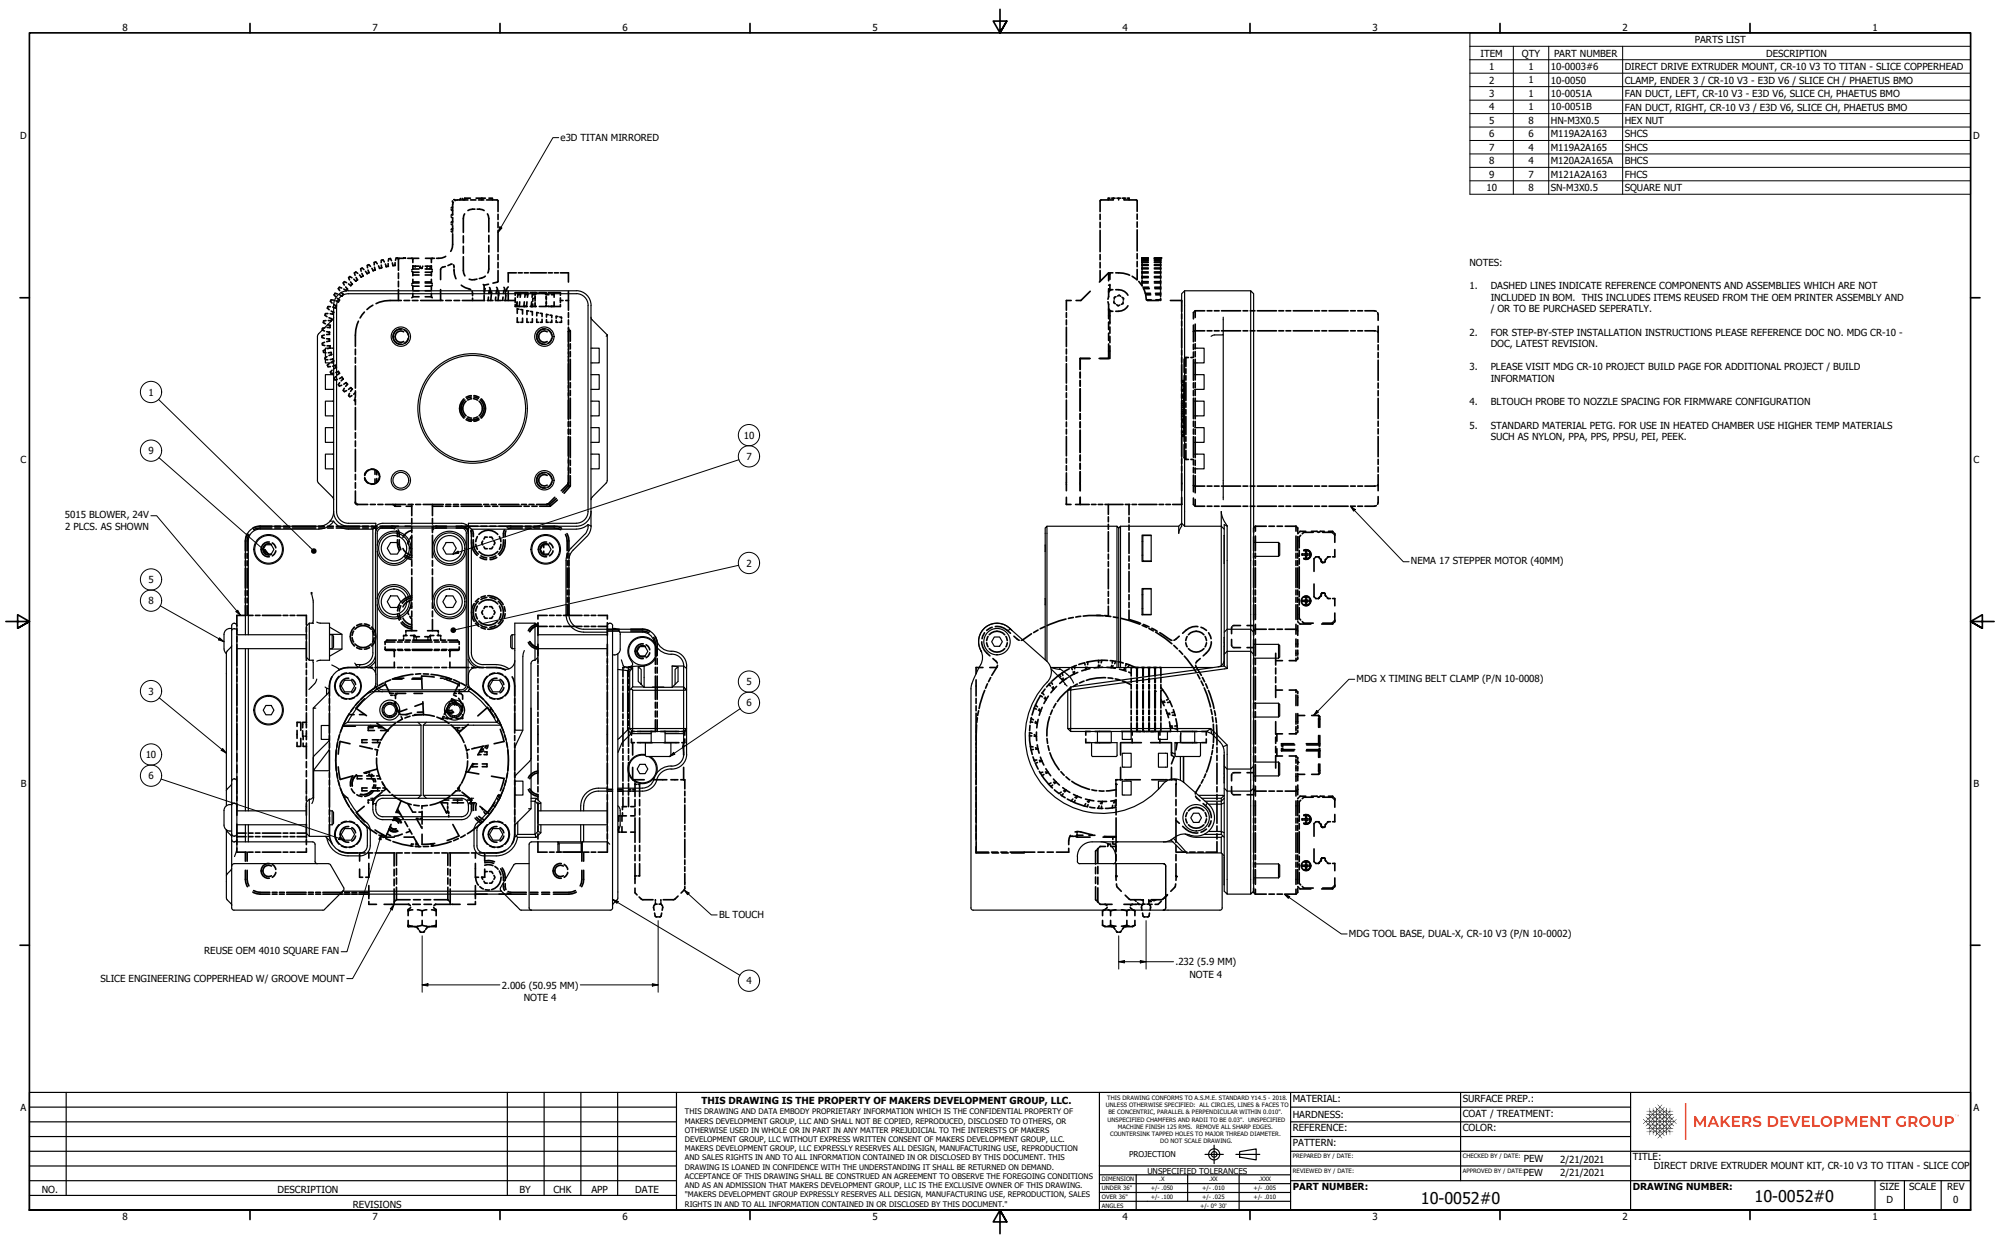
[picture p23: page 1]
PART NUMBER:; DRAWING NUMBER:; REV; SURFACE PREP.:; BL TOUCH; e3D TITAN MIRRORED; 2.006 (50.95 MM) NOTE 4; .232 (5.9 MM) NOTE 4

PARTS LIST

ITEM | QTY | PART NUMBER | DESCRIPTION
1 | 1 | 10-0003#6 | DIRECT DRIVE EXTRUDER MOUNT, CR-10 V3 TO TITAN - SLICE COPPERHEAD
2 | 1 | 10-0050 | CLAMP, ENDER 3 / CR-10 V3 - E3D V6 / SLICE CH / PHAETUS BMO
3 | 1 | 10-0051A | FAN DUCT, LEFT, CR-10 V3 - E3D V6, SLICE CH, PHAETUS BMO
4 | 1 | 10-0051B | FAN DUCT, RIGHT, CR-10 V3 / E3D V6, SLICE CH, PHAETUS BMO
5 | 8 | HN-M3X0.5 | HEX NUT
6 | 6 | M119A2A163 | SHCS
7 | 4 | M119A2A165 | SHCS
8 | 4 | M120A2A165A | BHCS
9 | 7 | M121A2A163 | FHCS
10 | 8 | SN-M3X0.5 | SQUARE NUT

1. DASHED LINES INDICATE REFERENCE COMPONENTS AND ASSEMBLIES WHICH ARE NOT
INCLUDED IN BOM. THIS INCLUDES ITEMS REUSED FROM THE OEM PRINTER ASSEMBLY AND
/ OR TO BE PURCHASED SEPERATLY.

2. FOR STEP-BY-STEP INSTALLATION INSTRUCTIONS PLEASE REFERENCE DOC NO. MDG CR-10 -
DOC, LATEST REVISION.

3. PLEASE VISIT MDG CR-10 PROJECT BUILD PAGE FOR ADDITIONAL PROJECT / BUILD
INFORMATION

4. BLTOUCH PROBE TO NOZZLE SPACING FOR FIRMWARE CONFIGURATION

5. STANDARD MATERIAL PETG. FOR USE IN HEATED CHAMBER USE HIGHER TEMP MATERIALS
SUCH AS NYLON, PPA, PPS, PPSU, PEI, PEEK.

5015 BLOWER, 24V
2 PLCS. AS SHOWN

NEMA 17 STEPPER MOTOR (40MM)

MDG X TIMING BELT CLAMP (P/N 10-0008)

MDG TOOL BASE, DUAL-X, CR-10 V3 (P/N 10-0002)

REUSE OEM 4010 SQUARE FAN

SLICE ENGINEERING COPPERHEAD W/ GROOVE MOUNT

THIS DRAWING CONFORMS TO A.S.M.E. STANDARD Y14.5 - 2018.
UNLESS OTHERWISE SPECIFIED: ALL CIRCLES, LINES & FACES TO
BE CONCENTRIC, PARALLEL & PERPENDICULAR WITHIN 0.010".
UNSPECIFIED CHAMFERS AND RADII TO BE 0.03". UNSPECIFIED
MACHINE FINISH 125 RMS. REMOVE ALL SHARP EDGES.
COUNTERSINK TAPPED HOLES TO MAJOR THREAD DIAMETER.

THIS DRAWING IS THE PROPERTY OF MAKERS DEVELOPMENT GROUP, LLC.
THIS DRAWING AND DATA EMBODY PROPRIETARY INFORMATION WHICH IS THE CONFIDENTIAL PROPERTY OF
MAKERS DEVELOPMENT GROUP, LLC AND SHALL NOT BE COPIED, REPRODUCED, DISCLOSED TO OTHERS, OR
OTHERWISE USED IN WHOLE OR IN PART IN ANY MATTER PREJUDICIAL TO THE INTERESTS OF MAKERS
DEVELOPMENT GROUP, LLC WITHOUT EXPRESS WRITTEN CONSENT OF MAKERS DEVELOPMENT GROUP, LLC.
MAKERS DEVELOPMENT GROUP, LLC EXPRESSLY RESERVES ALL DESIGN, MANUFACTURING USE, REPRODUCTION
AND SALES RIGHTS IN AND TO ALL INFORMATION CONTAINED IN OR DISCLOSED BY THIS DOCUMENT. THIS
DRAWING IS LOANED IN CONFIDENCE WITH THE UNDERSTANDING IT SHALL BE RETURNED ON DEMAND.
ACCEPTANCE OF THIS DRAWING SHALL BE CONSTRUED AN AGREEMENT TO OBSERVE THE FOREGOING CONDITIONS
AND AS AN ADMISSION THAT MAKERS DEVELOPMENT GROUP, LLC IS THE EXCLUSIVE OWNER OF THIS DRAWING.
"MAKERS DEVELOPMENT GROUP EXPRESSLY RESERVES ALL DESIGN, MANUFACTURING USE, REPRODUCTION, SALES
RIGHTS IN AND TO ALL INFORMATION CONTAINED IN OR DISCLOSED BY THIS DOCUMENT."

HARDNESS: | COAT / TREATMENT:
REFERENCE: | COLOR:
PATTERN:
PREPARED BY / DATE: | CHECKED BY / DATE: PEW 2/21/2021 | TITLE: DIRECT DRIVE EXTRUDER MOUNT KIT, CR-10 V3 TO TITAN - SLICE COP

DO NOT SCALE DRAWING.

UNSPECIFIED TOLERANCES | REVIEWED BY / DATE: | APPROVED BY / DATE: PEW 2/21/2021

DIMENSION | .X | .XX | .XXX
UNDER 36" | +/- .050 | +/- .010 | +/- .005
OVER 36" | +/- .100 | +/- .025 | +/- .010
ANGLES | +/- 0° 30'
