MAKERS-DEVELOPMENT-GROUP/MDG-CR-10-V3-Project/ASSEMBLY DRAWINGS/10-0030.pdf

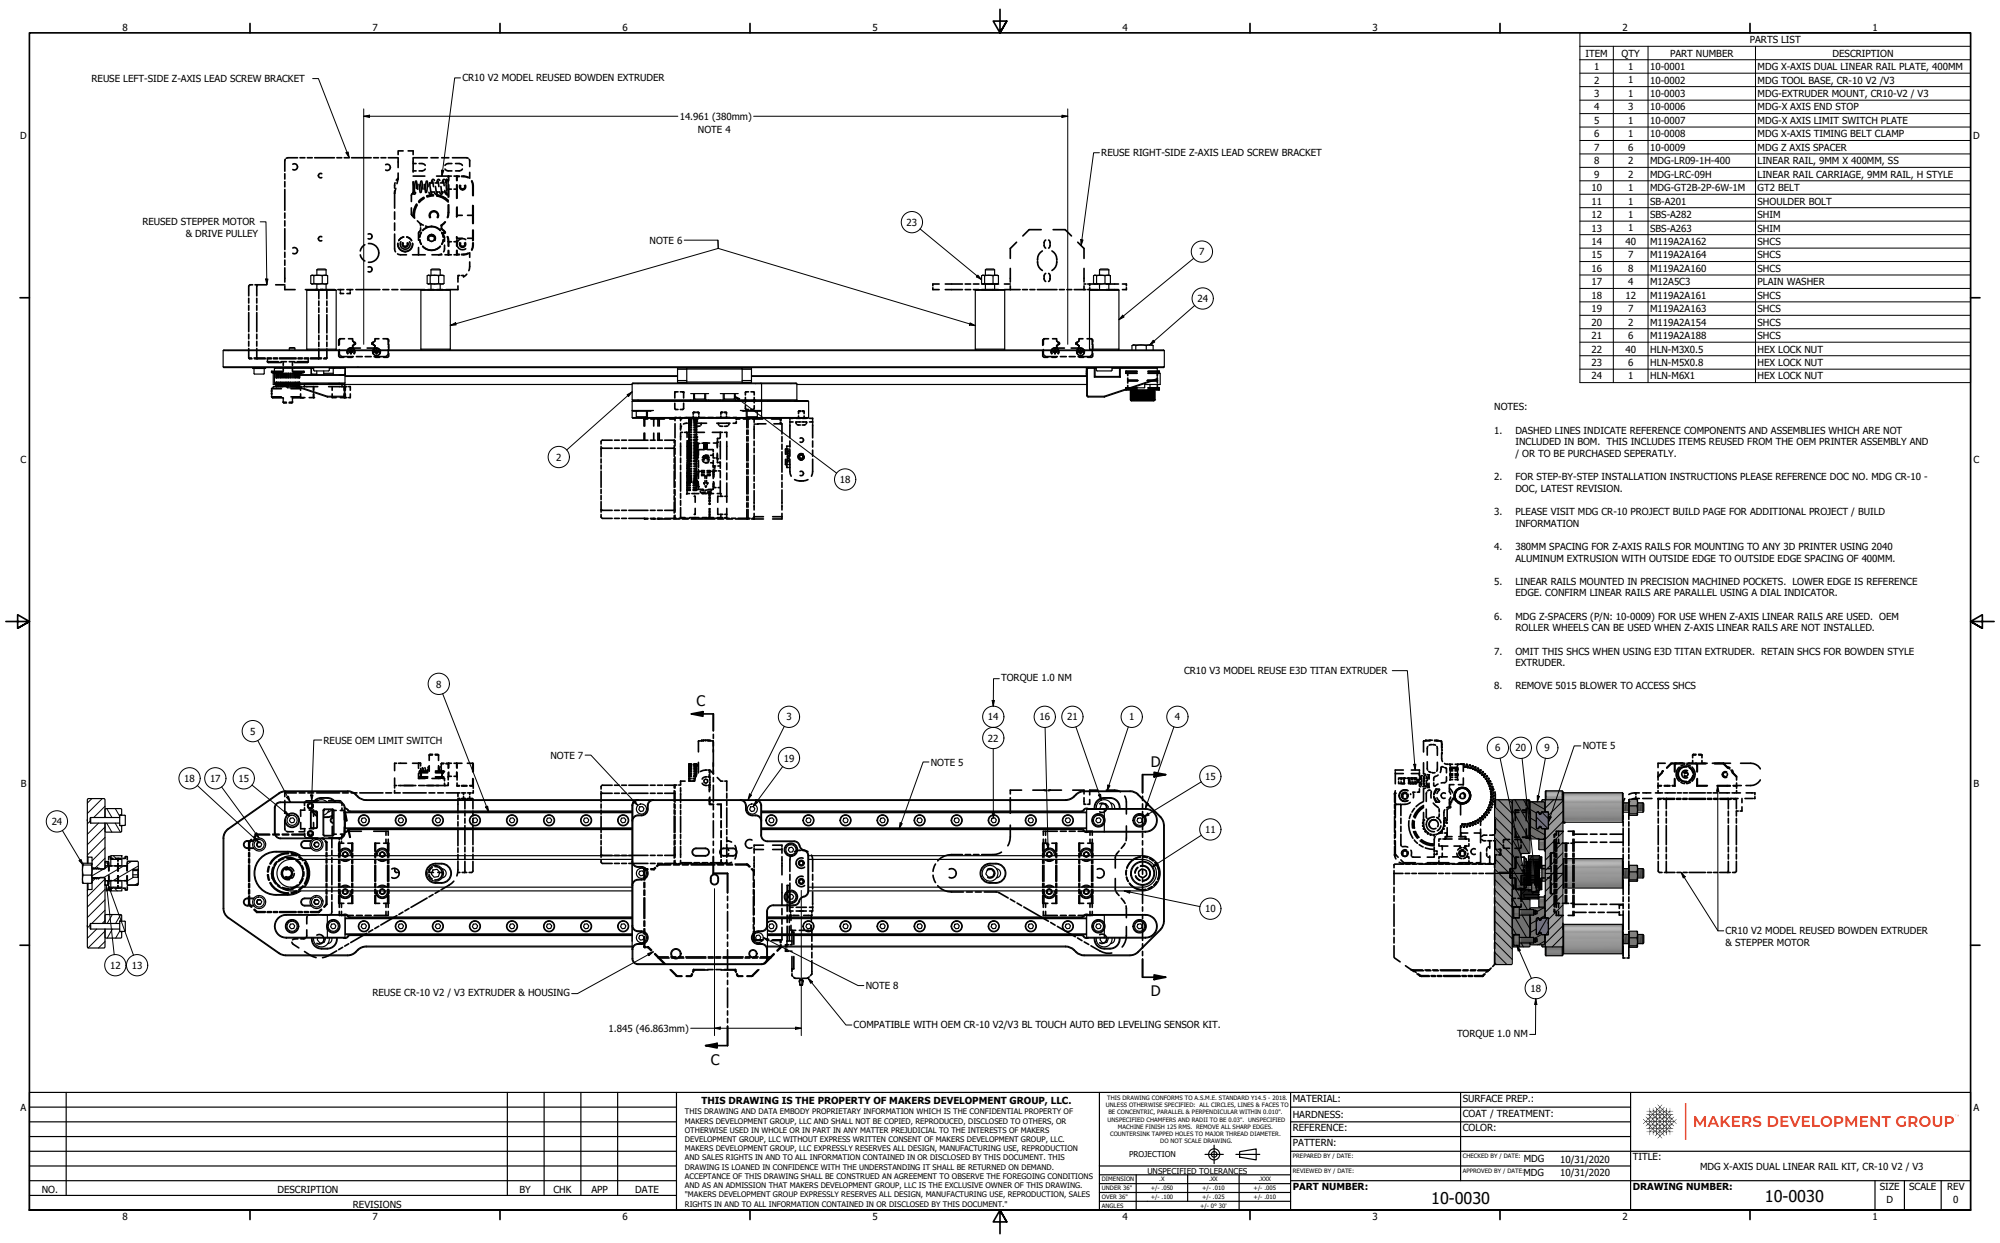
[picture p24: page 1]
PARTS LIST; ITEM; QTY; PART NUMBER; DESCRIPTION; MDG X-AXIS DUAL LINEAR RAIL PLATE, 400MM; MDG TOOL BASE, CR-10 V2 /V3; MDG-EXTRUDER MOUNT, CR10-V2 / V3; MDG-X AXIS END STOP; MDG-X AXIS LIMIT SWITCH PLATE; MDG X-AXIS TIMING BELT CLAMP; MDG Z AXIS SPACER; MDG-LR09-1H-400; LINEAR RAIL, 9MM X 400MM, SS; MDG-LRC-09H; LINEAR RAIL CARRIAGE, 9MM RAIL, H STYLE; MDG-GT2B-2P-6W-1M; GT2 BELT; SHOULDER BOLT; PLAIN WASHER; HLN-M3X0.5; HEX LOCK NUT; HLN-M5X0.8; HLN-M6X1; UNSPECIFIED TOLERANCES; UNDER 36"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

REUSE LEFT-SIDE Z-AXIS LEAD SCREW BRACKET

CR10 V2 MODEL REUSED BOWDEN EXTRUDER

REUSE RIGHT-SIDE Z-AXIS LEAD SCREW BRACKET

REUSED STEPPER MOTOR

1. DASHED LINES INDICATE REFERENCE COMPONENTS AND ASSEMBLIES WHICH ARE NOT
INCLUDED IN BOM. THIS INCLUDES ITEMS REUSED FROM THE OEM PRINTER ASSEMBLY AND
/ OR TO BE PURCHASED SEPERATLY.

2. FOR STEP-BY-STEP INSTALLATION INSTRUCTIONS PLEASE REFERENCE DOC NO. MDG CR-10 -
DOC, LATEST REVISION.

3. PLEASE VISIT MDG CR-10 PROJECT BUILD PAGE FOR ADDITIONAL PROJECT / BUILD
INFORMATION

4. 380MM SPACING FOR Z-AXIS RAILS FOR MOUNTING TO ANY 3D PRINTER USING 2040
ALUMINUM EXTRUSION WITH OUTSIDE EDGE TO OUTSIDE EDGE SPACING OF 400MM.

5. LINEAR RAILS MOUNTED IN PRECISION MACHINED POCKETS. LOWER EDGE IS REFERENCE
EDGE. CONFIRM LINEAR RAILS ARE PARALLEL USING A DIAL INDICATOR.

6. MDG Z-SPACERS (P/N: 10-0009) FOR USE WHEN Z-AXIS LINEAR RAILS ARE USED. OEM
ROLLER WHEELS CAN BE USED WHEN Z-AXIS LINEAR RAILS ARE NOT INSTALLED.

7. OMIT THIS SHCS WHEN USING E3D TITAN EXTRUDER. RETAIN SHCS FOR BOWDEN STYLE
EXTRUDER.

CR10 V3 MODEL REUSE E3D TITAN EXTRUDER

8. REMOVE 5015 BLOWER TO ACCESS SHCS

REUSE OEM LIMIT SWITCH

& STEPPER MOTOR

REUSE CR-10 V2 / V3 EXTRUDER & HOUSING

COMPATIBLE WITH OEM CR-10 V2/V3 BL TOUCH AUTO BED LEVELING SENSOR KIT.

THIS DRAWING CONFORMS TO A.S.M.E. STANDARD Y14.5 - 2018.
UNLESS OTHERWISE SPECIFIED: ALL CIRCLES, LINES & FACES TO
BE CONCENTRIC, PARALLEL & PERPENDICULAR WITHIN 0.010".
UNSPECIFIED CHAMFERS AND RADII TO BE 0.03". UNSPECIFIED
MACHINE FINISH 125 RMS. REMOVE ALL SHARP EDGES.
COUNTERSINK TAPPED HOLES TO MAJOR THREAD DIAMETER.

THIS DRAWING IS THE PROPERTY OF MAKERS DEVELOPMENT GROUP, LLC.
THIS DRAWING AND DATA EMBODY PROPRIETARY INFORMATION WHICH IS THE CONFIDENTIAL PROPERTY OF
MAKERS DEVELOPMENT GROUP, LLC AND SHALL NOT BE COPIED, REPRODUCED, DISCLOSED TO OTHERS, OR
OTHERWISE USED IN WHOLE OR IN PART IN ANY MATTER PREJUDICIAL TO THE INTERESTS OF MAKERS
DEVELOPMENT GROUP, LLC WITHOUT EXPRESS WRITTEN CONSENT OF MAKERS DEVELOPMENT GROUP, LLC.
MAKERS DEVELOPMENT GROUP, LLC EXPRESSLY RESERVES ALL DESIGN, MANUFACTURING USE, REPRODUCTION
AND SALES RIGHTS IN AND TO ALL INFORMATION CONTAINED IN OR DISCLOSED BY THIS DOCUMENT. THIS
DRAWING IS LOANED IN CONFIDENCE WITH THE UNDERSTANDING IT SHALL BE RETURNED ON DEMAND.
ACCEPTANCE OF THIS DRAWING SHALL BE CONSTRUED AN AGREEMENT TO OBSERVE THE FOREGOING CONDITIONS
AND AS AN ADMISSION THAT MAKERS DEVELOPMENT GROUP, LLC IS THE EXCLUSIVE OWNER OF THIS DRAWING.
"MAKERS DEVELOPMENT GROUP EXPRESSLY RESERVES ALL DESIGN, MANUFACTURING USE, REPRODUCTION, SALES
RIGHTS IN AND TO ALL INFORMATION CONTAINED IN OR DISCLOSED BY THIS DOCUMENT."

DO NOT SCALE DRAWING.

PREPARED BY / DATE:

CHECKED BY / DATE:

MDG X-AXIS DUAL LINEAR RAIL KIT, CR-10 V2 / V3

REVIEWED BY / DATE:
PART NUMBER:

APPROVED BY / DATE:
