MAKERS-DEVELOPMENT-GROUP/MDG-CR-10-V3-Project/ASSEMBLY DRAWINGS/10-0031.pdf

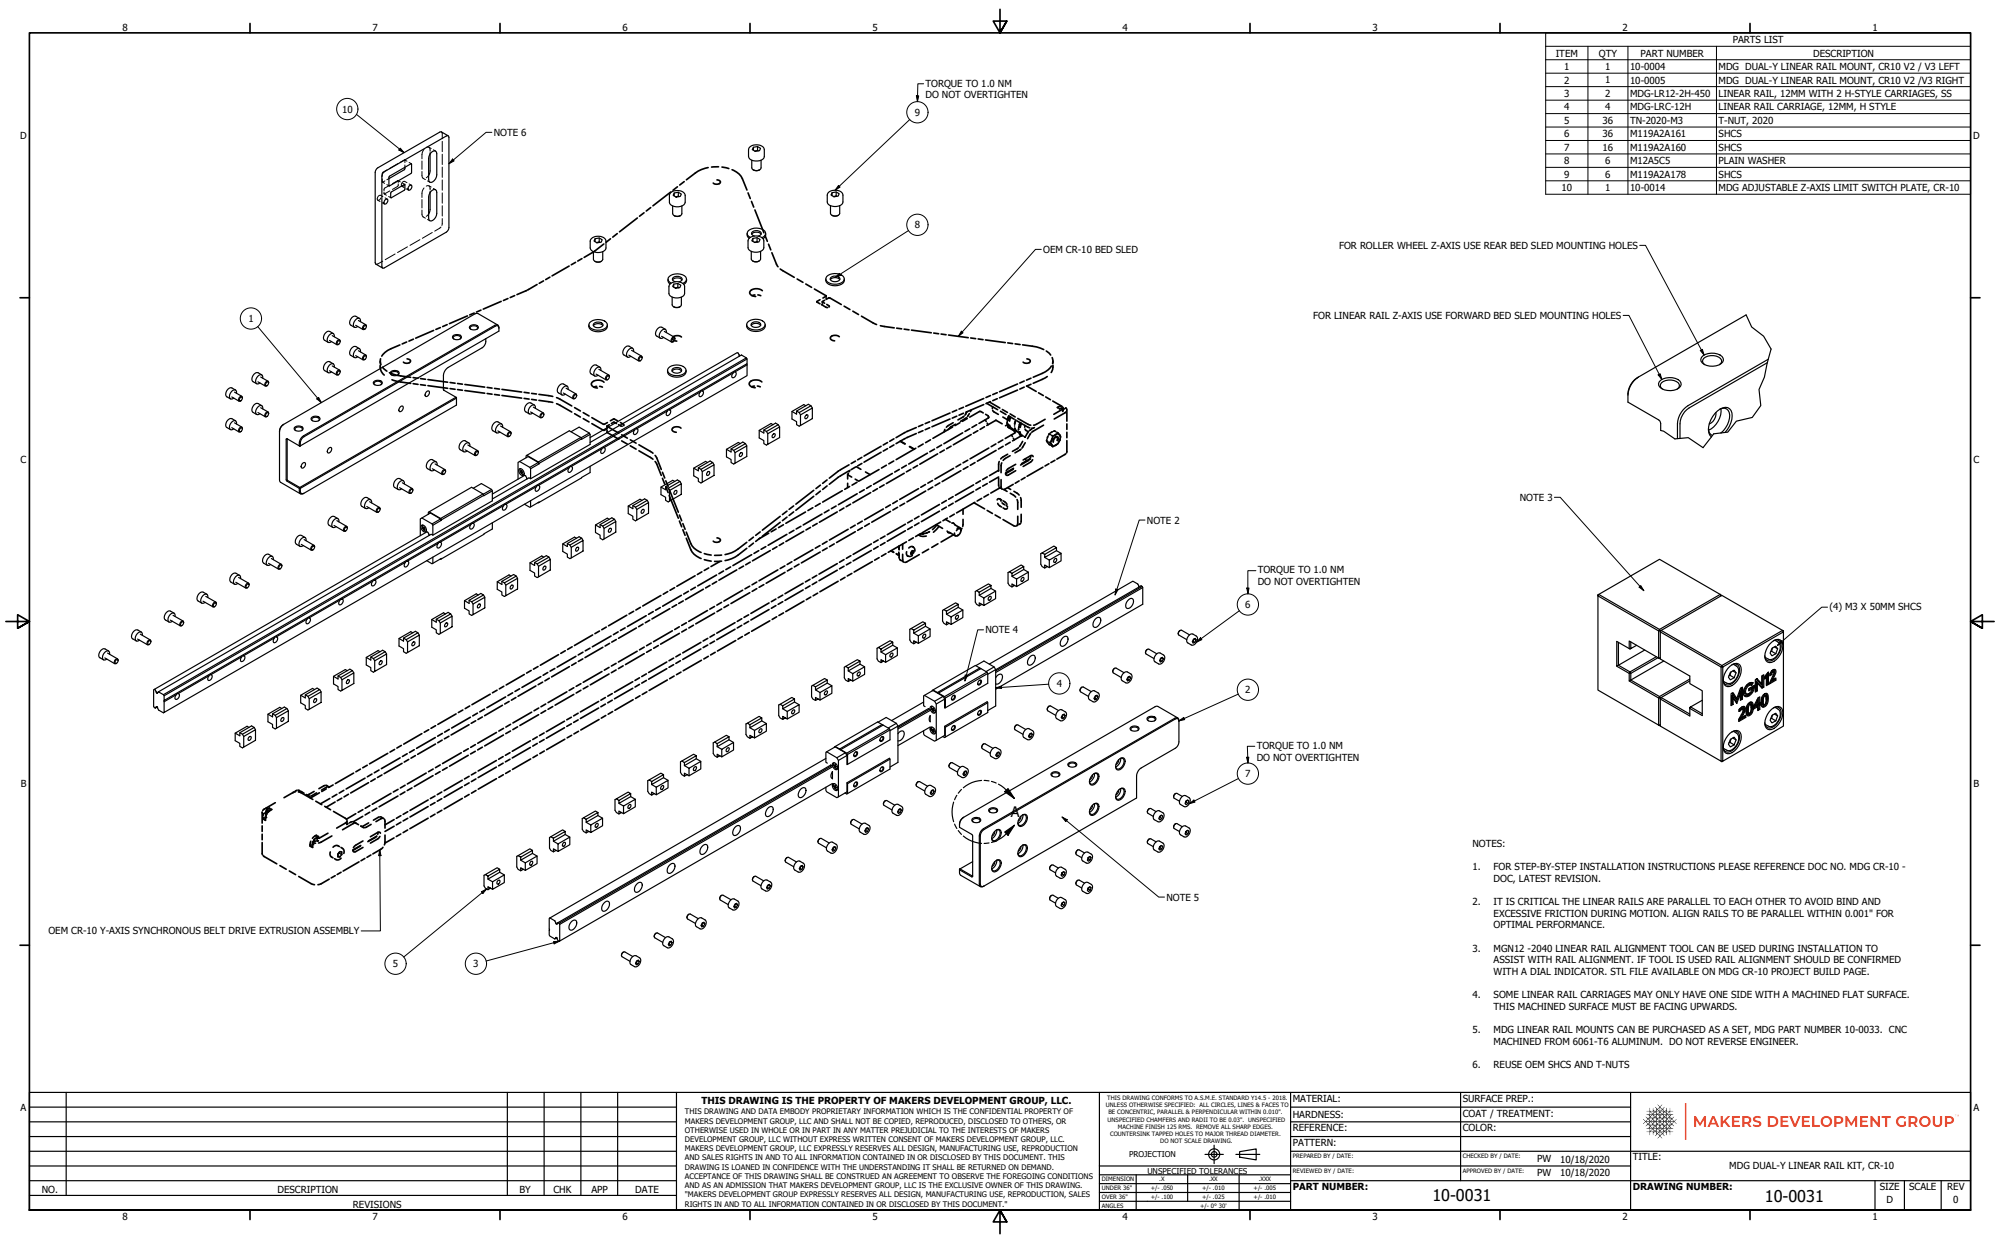
[picture p25: page 1]
PART NUMBER:; DRAWING NUMBER:; REV; SURFACE PREP.:; NOTE 4; NOTE 2; NOTE 3; (4) M3 X 50MM SHCS; NOTE 5; NOTE 6

PARTS LIST

ITEM | QTY | PART NUMBER | DESCRIPTION
1 | 1 | 10-0004 | MDG DUAL-Y LINEAR RAIL MOUNT, CR10 V2 / V3 LEFT
2 | 1 | 10-0005 | MDG DUAL-Y LINEAR RAIL MOUNT, CR10 V2 /V3 RIGHT
3 | 2 | MDG-LR12-2H-450 | LINEAR RAIL, 12MM WITH 2 H-STYLE CARRIAGES, SS
4 | 4 | MDG-LRC-12H | LINEAR RAIL CARRIAGE, 12MM, H STYLE
5 | 36 | TN-2020-M3 | T-NUT, 2020
6 | 36 | M119A2A161 | SHCS
7 | 16 | M119A2A160 | SHCS
8 | 6 | M12A5C5 | PLAIN WASHER
9 | 6 | M119A2A178 | SHCS
10 | 1 | 10-0014 | MDG ADJUSTABLE Z-AXIS LIMIT SWITCH PLATE, CR-10

TORQUE TO 1.0 NM
DO NOT OVERTIGHTEN

FOR ROLLER WHEEL Z-AXIS USE REAR BED SLED MOUNTING HOLES

OEM CR-10 BED SLED

FOR LINEAR RAIL Z-AXIS USE FORWARD BED SLED MOUNTING HOLES

1. FOR STEP-BY-STEP INSTALLATION INSTRUCTIONS PLEASE REFERENCE DOC NO. MDG CR-10 -
DOC, LATEST REVISION.

2. IT IS CRITICAL THE LINEAR RAILS ARE PARALLEL TO EACH OTHER TO AVOID BIND AND
EXCESSIVE FRICTION DURING MOTION. ALIGN RAILS TO BE PARALLEL WITHIN 0.001" FOR
OPTIMAL PERFORMANCE.

OEM CR-10 Y-AXIS SYNCHRONOUS BELT DRIVE EXTRUSION ASSEMBLY

3. MGN12 -2040 LINEAR RAIL ALIGNMENT TOOL CAN BE USED DURING INSTALLATION TO
ASSIST WITH RAIL ALIGNMENT. IF TOOL IS USED RAIL ALIGNMENT SHOULD BE CONFIRMED
WITH A DIAL INDICATOR. STL FILE AVAILABLE ON MDG CR-10 PROJECT BUILD PAGE.

4. SOME LINEAR RAIL CARRIAGES MAY ONLY HAVE ONE SIDE WITH A MACHINED FLAT SURFACE.
THIS MACHINED SURFACE MUST BE FACING UPWARDS.

5. MDG LINEAR RAIL MOUNTS CAN BE PURCHASED AS A SET, MDG PART NUMBER 10-0033. CNC
MACHINED FROM 6061-T6 ALUMINUM. DO NOT REVERSE ENGINEER.

6. REUSE OEM SHCS AND T-NUTS

THIS DRAWING CONFORMS TO A.S.M.E. STANDARD Y14.5 - 2018.
UNLESS OTHERWISE SPECIFIED: ALL CIRCLES, LINES & FACES TO
BE CONCENTRIC, PARALLEL & PERPENDICULAR WITHIN 0.010".
UNSPECIFIED CHAMFERS AND RADII TO BE 0.03". UNSPECIFIED
MACHINE FINISH 125 RMS. REMOVE ALL SHARP EDGES.
COUNTERSINK TAPPED HOLES TO MAJOR THREAD DIAMETER.

THIS DRAWING IS THE PROPERTY OF MAKERS DEVELOPMENT GROUP, LLC.
THIS DRAWING AND DATA EMBODY PROPRIETARY INFORMATION WHICH IS THE CONFIDENTIAL PROPERTY OF
MAKERS DEVELOPMENT GROUP, LLC AND SHALL NOT BE COPIED, REPRODUCED, DISCLOSED TO OTHERS, OR
OTHERWISE USED IN WHOLE OR IN PART IN ANY MATTER PREJUDICIAL TO THE INTERESTS OF MAKERS
DEVELOPMENT GROUP, LLC WITHOUT EXPRESS WRITTEN CONSENT OF MAKERS DEVELOPMENT GROUP, LLC.
MAKERS DEVELOPMENT GROUP, LLC EXPRESSLY RESERVES ALL DESIGN, MANUFACTURING USE, REPRODUCTION
AND SALES RIGHTS IN AND TO ALL INFORMATION CONTAINED IN OR DISCLOSED BY THIS DOCUMENT. THIS
DRAWING IS LOANED IN CONFIDENCE WITH THE UNDERSTANDING IT SHALL BE RETURNED ON DEMAND.
ACCEPTANCE OF THIS DRAWING SHALL BE CONSTRUED AN AGREEMENT TO OBSERVE THE FOREGOING CONDITIONS
AND AS AN ADMISSION THAT MAKERS DEVELOPMENT GROUP, LLC IS THE EXCLUSIVE OWNER OF THIS DRAWING.
"MAKERS DEVELOPMENT GROUP EXPRESSLY RESERVES ALL DESIGN, MANUFACTURING USE, REPRODUCTION, SALES
RIGHTS IN AND TO ALL INFORMATION CONTAINED IN OR DISCLOSED BY THIS DOCUMENT."

HARDNESS: | COAT / TREATMENT:
REFERENCE: | COLOR:
PATTERN:
PREPARED BY / DATE: | CHECKED BY / DATE: PW 10/18/2020 | TITLE: MDG DUAL-Y LINEAR RAIL KIT, CR-10

DO NOT SCALE DRAWING.

UNSPECIFIED TOLERANCES | REVIEWED BY / DATE: | APPROVED BY / DATE: PW 10/18/2020

DIMENSION | .X | .XX | .XXX
UNDER 36" | +/- .050 | +/- .010 | +/- .005
OVER 36" | +/- .100 | +/- .025 | +/- .010
ANGLES | +/- 0° 30'
